etherkit/OpenBeacon2/README.md

# OpenBeacon 2

Documentation for the OpenBeacon 2 Multimode MEPT, which is based on the OpenBeacon project.

## Quick Start

Please visit the [Quick Start Guide](documentation/QuickStart.md) for instructions on how to get up and running with OpenBeacon 2 and for how to use the most common commands.
