etherkit/OpenBeacon2/mechanical/OpenBeacon 2 Acrylic.dxf

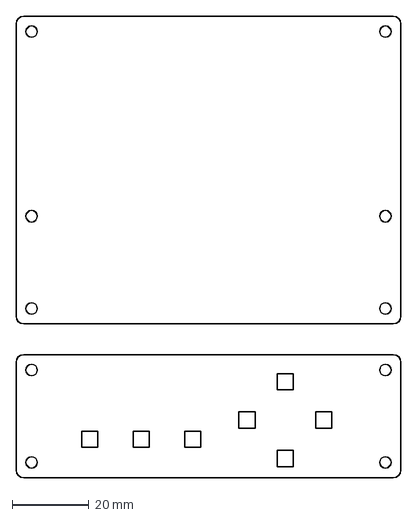
[picture p1: CAD file, 2018-11-19]
mechanical/OpenBeacon 2 Acrylic.dxf
100.0 x 120.0 mm
