etherkit/OpenBeacon2/(threads)

Thread 1 (2019-12-24):

Feature Request - Verbose Mode on Console Command Line

AA7US, 2019-12-24:
When sending commands from the ob2sync console to the OB2, it'd be helpful to receive back some indication like “OK” when a command is understood and successful.  If a command is not recognized or is unsuccessful, receiving back something like “ERR” or “?” would be helpful.  Currently no indication is returned when a command isn't understood by the OB2 firmware.

Thread 2 (2019-12-24):

Feature Request - JS8 Mode

AA7US, 2019-12-24:
Please consider adding JS8 mode transmissions.

JS8 is a free-form chat derivative of FT8 and has 4 speeds.  The Slow speed (30 second transmission at 25 Hz wide) and Normal speed (15 second transmission at 50 Hz wide) would likely be appropriate for the OB2's power level.

See: [http://js8call.com](url)

Source code repository: [https://bitbucket.org/widefido/js8call/src/js8call/](url)

NT7S, 2019-12-24:
This is definitely on my radar. Will add it to the JTEncode repo.

Thread 4 (2020-06-25):

Bug Report - Band Pass Modules "Empty"

AA7US, 2020-06-25:
When firmware dated 12/30/2019 is loaded into Empyrean, the Linux ARM client will report band pass modules are empty in response to "list bands."  Immediately quitting and relaunching the client app eliminates this behavior.  If the Empyrean is reset, the bug comes back and client must again be quit and relaunched to clear it.  Previous firmware builds do not exhibit this bug.
