etherkit/OpenBeacon2/docs/OpenBeacon2_schematic.pdf

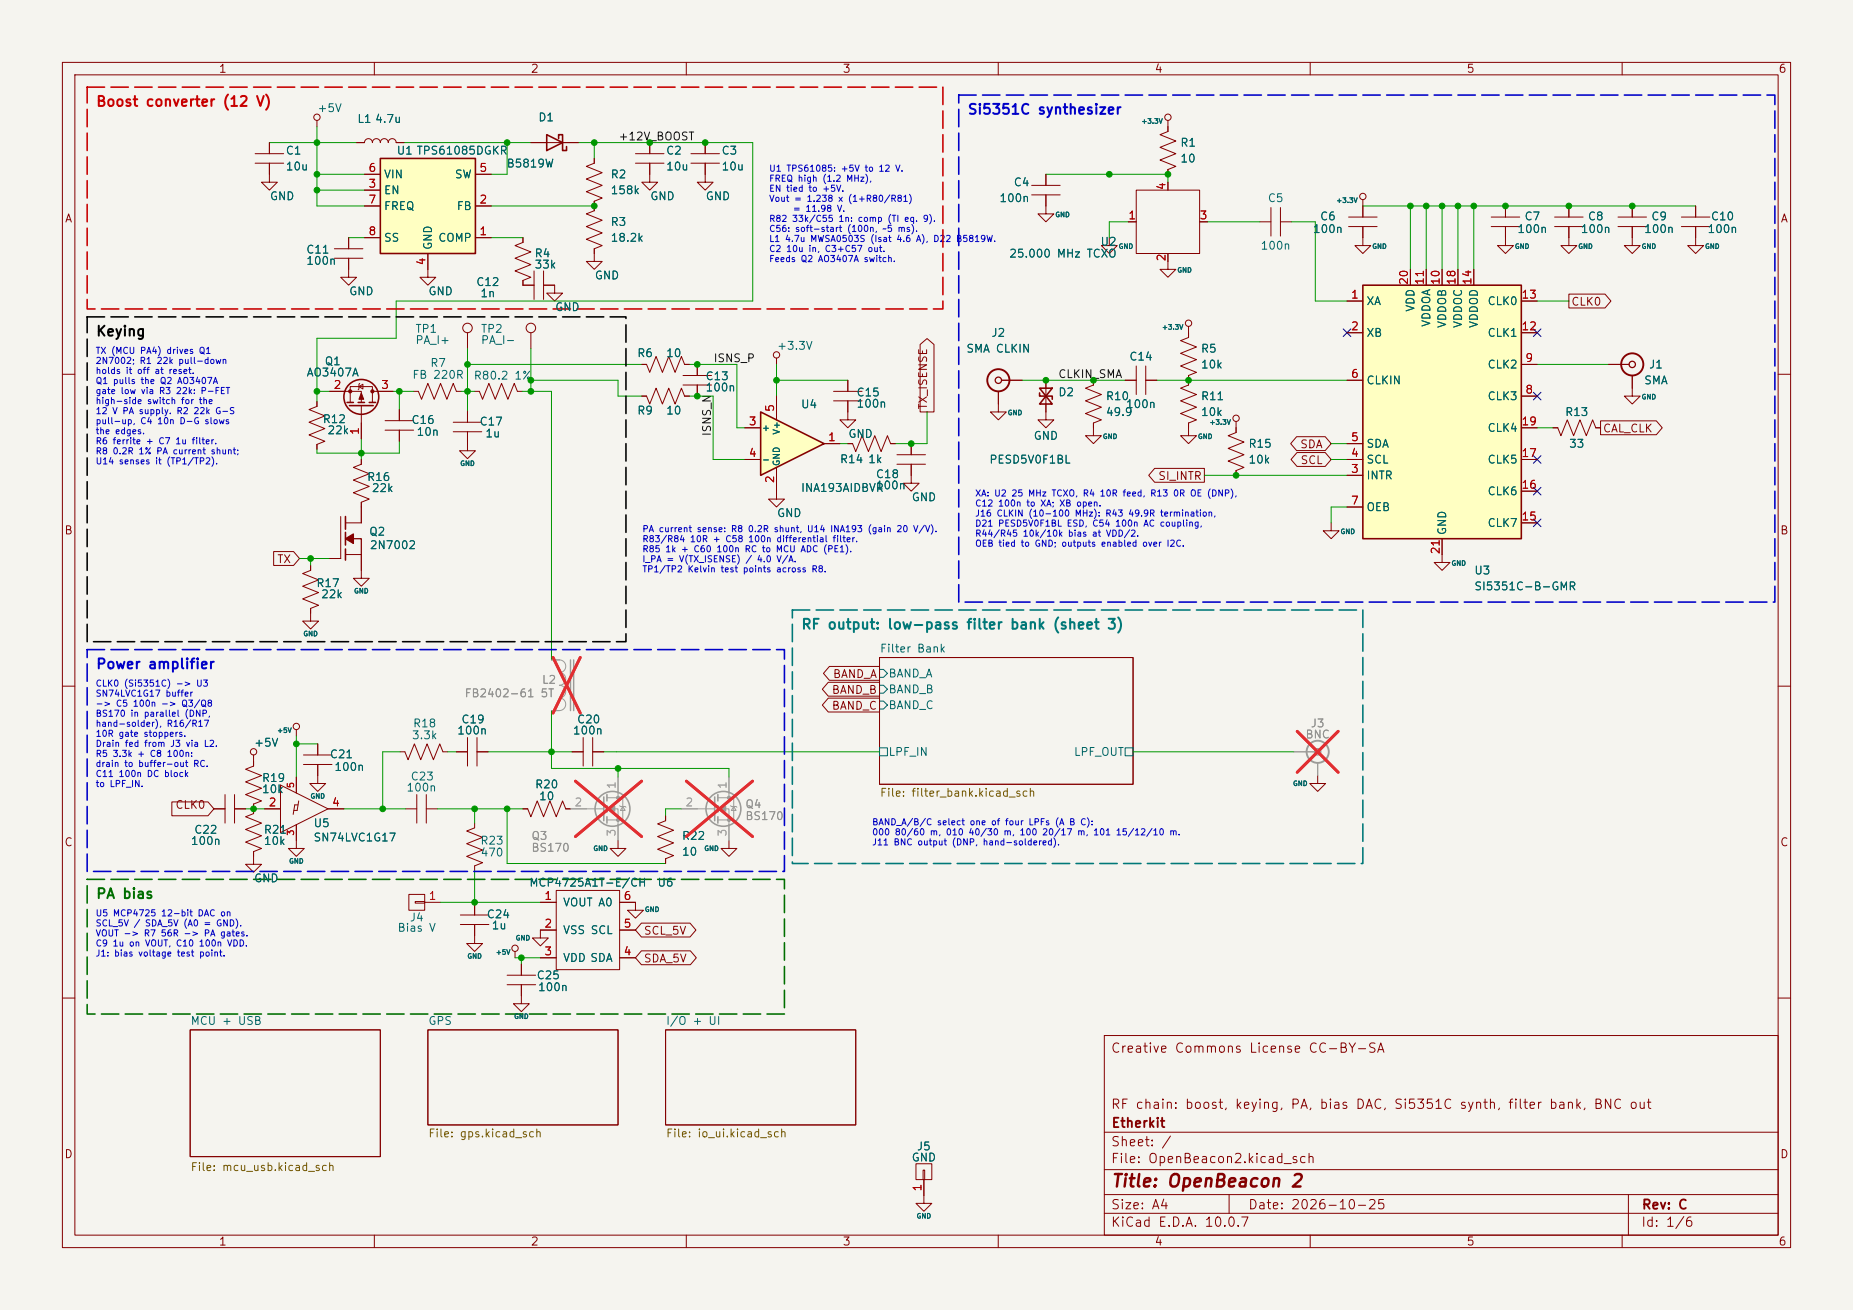
[picture p2: page 1]

ISNS_P +12V_BOOST PA current sense: R8 0.2R shunt, U14 INA193 (gain 20 V/V). R83/R84 10R + C58 100n differential filter. R85 1k + C60 100n RC to MCU ADC (PE1).

U1 TPS61085: +5V to 12 V. FREQ high (1.2 MHz), EN tied to +5V. Vout = 1.238 x (1+R80/R81) = 11.98 V. R82 33k/C55 1n: comp (TI eq. 9). C56: soft-start (100n, ~5 ms). L1 4.7u MWSA0503S (Isat 4.6 A), D22 B5819W. C2 10u in, C3+C57 out. Feeds Q2 AO3407A switch. RF output: low-pass filter bank (sheet 3)

TX (MCU PA4) drives Q1
2N7002; R1 22k pull-down
holds it off at reset. Q1 pulls the Q2 AO3407A gate low via R3 22k: P-FET high-side switch for the 12 V PA supply. R2 22k G-S

pull-up, C4 10n D-G slows
the edges. R6 ferrite + C7 1u filter. R8 0.2R 1% PA current shunt; U14 senses it (TP1/TP2).

SN74LVC1G17 buffer -> C5 100n -> Q3/Q8 BS170 in parallel (DNP, hand-solder), R16/R17

10R gate stoppers. Drain fed from J3 via L2. R5 3.3k + C8 100n: drain to buffer-out RC. C11 100n DC block

U5 MCP4725 12-bit DAC on SCL_5V / SDA_5V (A0 = GND). VOUT -> R7 56R -> PA gates. C9 1u on VOUT, C10 100n VDD. J1: bias voltage test point. PA bias

Creative Commons License CC-BY-SA MCU + USB

RF chain: boost, keying, PA, bias DAC, Si5351C synth, filter bank, BNC out
Etherkit
Sheet: /
File: OpenBeacon2.kicad_sch
Title: OpenBeacon 2

Size: A4 | Rev: C
KiCad E.D.A. 10.0.7 | Id: 1/6

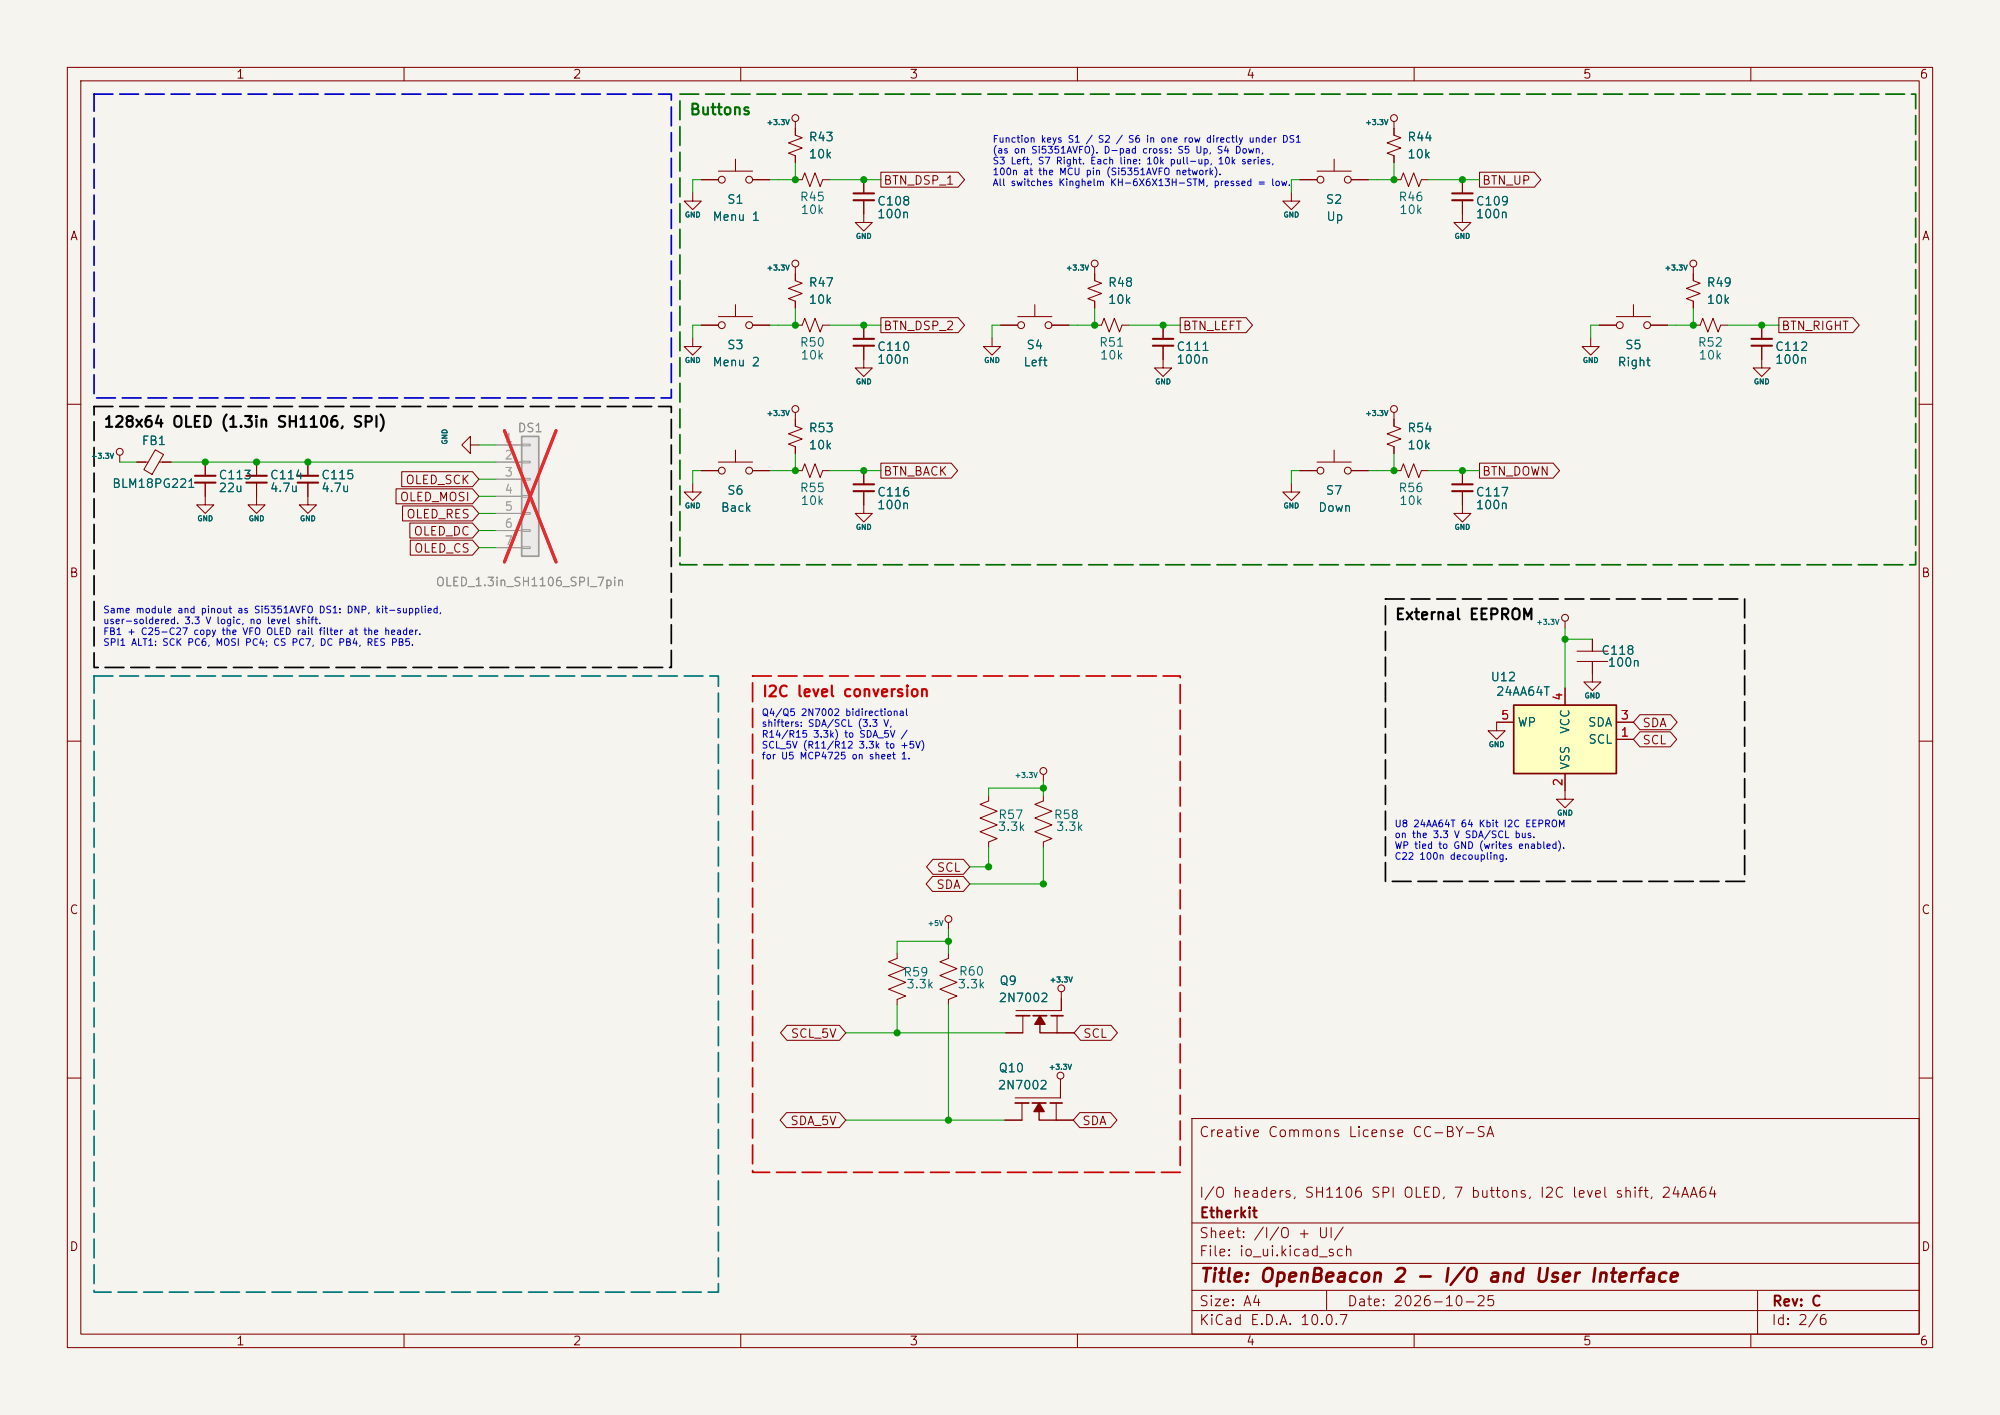
[picture p3: page 2]

Function keys S1 / S2 / S6 in one row directly under DS1

on the 3.3 V SDA/SCL bus. WP tied to GND (writes enabled). C22 100n decoupling. External EEPROM

for U5 MCP4725 on sheet 1. I2C level conversion

Creative Commons License CC-BY-SA

I/O headers, SH1106 SPI OLED, 7 buttons, I2C level shift, 24AA64
Etherkit
Sheet: /I/O + UI/
File: io_ui.kicad_sch
Title: OpenBeacon 2 - I/O and User Interface

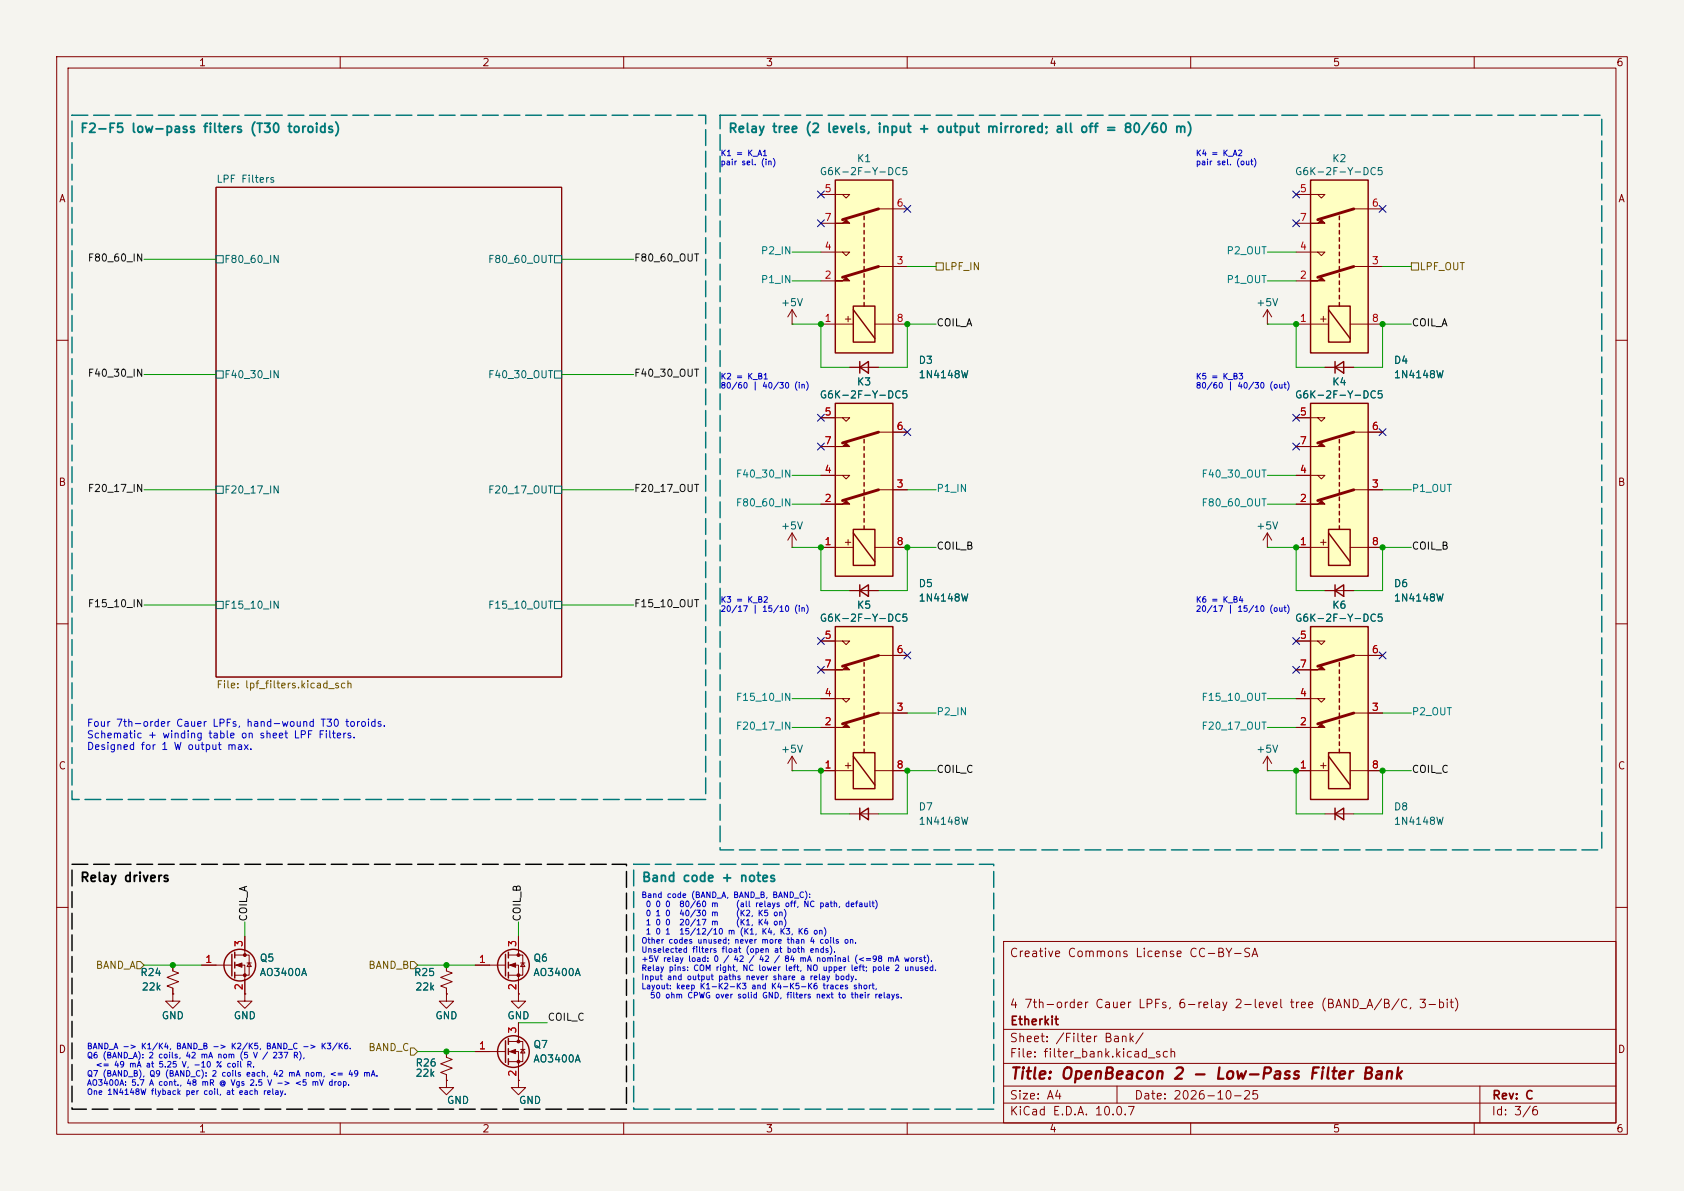
[picture p4: page 3]

F20_17_IN F2-F5 low-pass filters (T30 toroids)

Relay tree (2 levels, input + output mirrored; all off = 80/60 m)
pair sel. (in)

Input and output paths never share a relay body. Layout: keep K1-K2-K3 and K4-K5-K6 traces short, 50 ohm CPWG over solid GND, filters next to their relays. Q6

Creative Commons License CC-BY-SA

4 7th-order Cauer LPFs, 6-relay 2-level tree (BAND_A/B/C, 3-bit)
Etherkit
Sheet: /Filter Bank/
File: filter_bank.kicad_sch
Title: OpenBeacon 2 - Low-Pass Filter Bank

BAND_A -> K1/K4, BAND_B -> K2/K5, BAND_C -> K3/K6. Q6 (BAND_A): 2 coils, 42 mA nom (5 V / 237 R), <= 49 mA at 5.25 V, -10 % coil R. Q7 (BAND_B), Q9 (BAND_C): 2 coils each, 42 mA nom, <= 49 mA. AO3400A: 5.7 A cont., 48 mR @ Vgs 2.5 V -> <5 mV drop. One 1N4148W flyback per coil, at each relay.

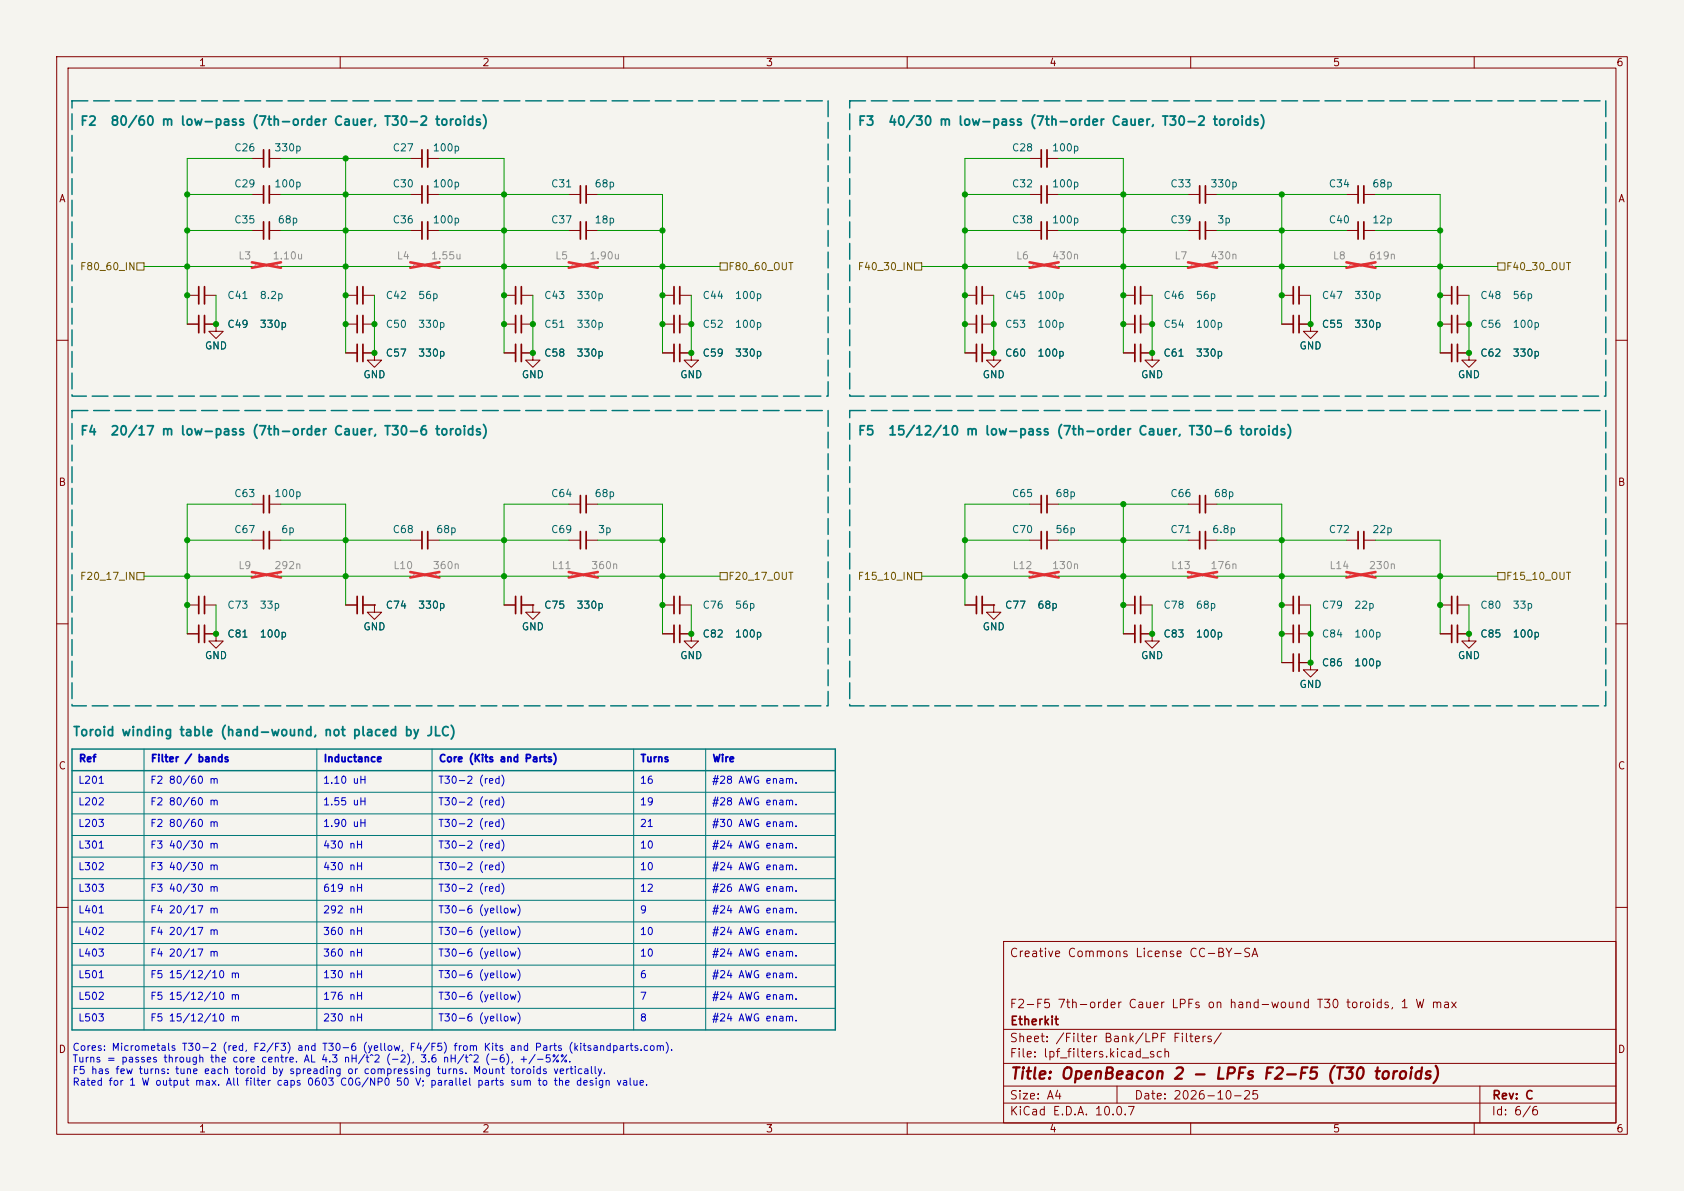
[picture p5: page 4]

F2 80/60 m low-pass (7th-order Cauer, T30-2 toroids)

F3 40/30 m low-pass (7th-order Cauer, T30-2 toroids)

F5 15/12/10 m low-pass (7th-order Cauer, T30-6 toroids)

Ref | Filter / bands | Inductance | | | #30 AWG enam. #28 AWG enam. Toroid winding table (hand-wound, not placed by JLC)

L301 | F3 40/30 m | 430 nH | T30-2 (red) | 19 Core (Kits and Parts) Turns | #24 AWG enam. F4 20/17 m

L203 | F2 80/60 m | 1.90 uH | T30-2 (red) | 12 21 | #26 AWG enam. T30-2 (red) T30-2 (red)
L201 | F2 80/60 m | 1.10 uH

L401 | F4 20/17 m | 292 nH | | 10 | #24 AWG enam. T30-6 (yellow) T30-2 (red)

L402 | | 360 nH | T30-6 (yellow)

F2-F5 7th-order Cauer LPFs on hand-wound T30 toroids, 1 W max Creative Commons License CC-BY-SA

Etherkit
Sheet: /Filter Bank/LPF Filters/
File: lpf_filters.kicad_sch
Title: OpenBeacon 2 - LPFs F2-F5 (T30 toroids)

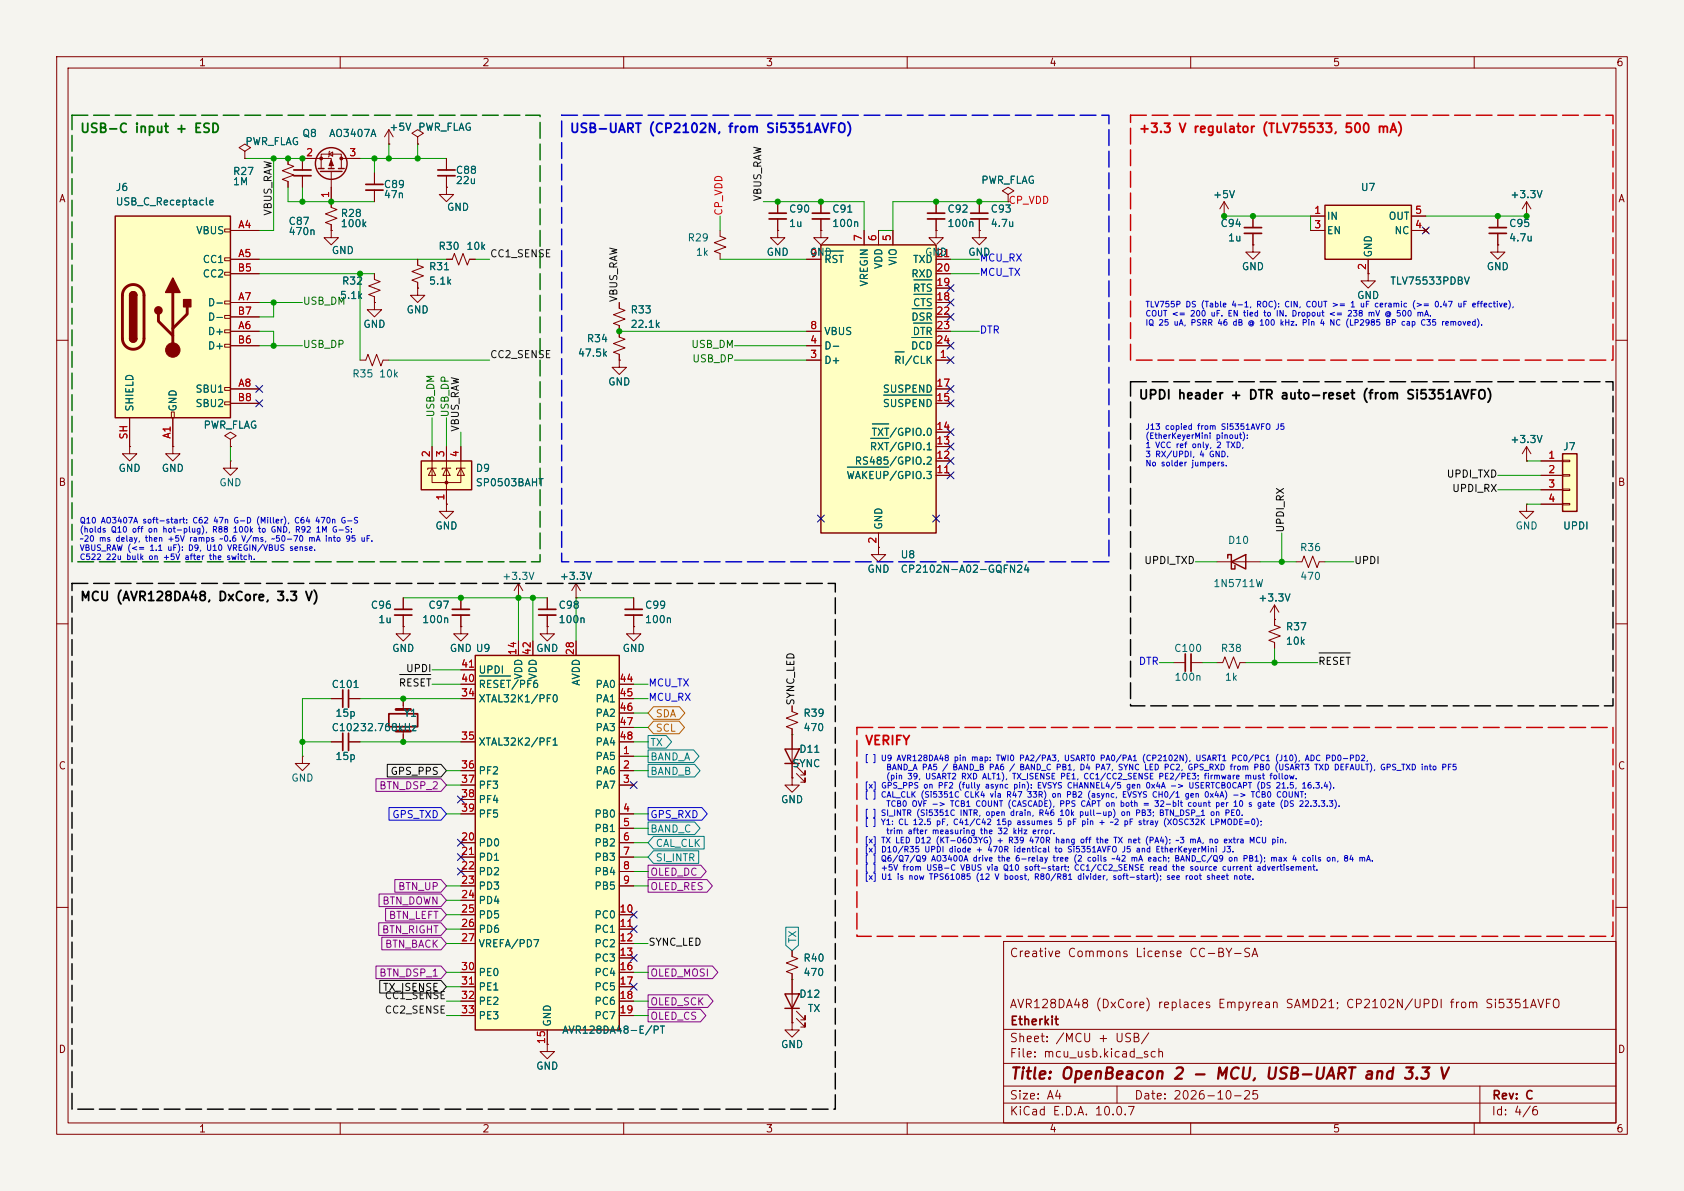
[picture p6: page 5]

SUSPEND 15 SUSPEND 17 CTS 18 RTS 19 RXD 20 TXD 21 DSR 22 DTR 23 DCD 24 U8CP2102N-A02-GQFN24 C91

SUSPEND 15 SUSPEND 17 CTS 18 RTS 19 RXD 20 TXD 21 DSR 22 DTR 23 DCD 24 C91

TLV755P DS (Table 4-1, ROC): CIN, COUT >= 1 uF ceramic (>= 0.47 uF effective), COUT <= 200 uF. EN tied to IN. Dropout <= 238 mV @ 500 mA.

IQ 25 uA, PSRR 46 dB @ 100 kHz. Pin 4 NC (LP2985 BP cap C35 removed).

Creative Commons License CC-BY-SA GND A1

(pin 39, USART2 RXD ALT1), TX_ISENSE PE1, CC1/CC2_SENSE PE2/PE3; firmware must follow. [x] GPS_PPS on PF2 (fully async pin): EVSYS CHANNEL4/5 gen 0x4A -> USERTCB0CAPT (DS 21.5, 16.3.4). [ ] CAL_CLK (Si5351C CLK4 via R47 33R) on PB2 (async, EVSYS CH0/1 gen 0x4A) -> TCB0 COUNT; TCB0 OVF -> TCB1 COUNT (CASCADE), PPS CAPT on both = 32-bit count per 10 s gate (DS 22.3.3.3). [ ] SI_INTR (Si5351C INTR, open drain, R46 10k pull-up) on PB3; BTN_DSP_1 on PE0. [ ] Y1: CL 12.5 pF, C41/C42 15p assumes 5 pF pin + ~2 pF stray (XOSC32K LPMODE=0); trim after measuring the 32 kHz error. [x] TX LED D12 (KT-0603YG) + R39 470R hang off the TX net (PA4); ~3 mA, no extra MCU pin. [x] D10/R35 UPDI diode + 470R identical to Si5351AVFO J5 and EtherKeyerMini J3. [ ] Q6/Q7/Q9 AO3400A drive the 6-relay tree (2 coils ~42 mA each; BAND_C/Q9 on PB1); max 4 coils on, 84 mA. [ ] +5V from USB-C VBUS via Q10 soft-start; CC1/CC2_SENSE read the source current advertisement. [x] U1 is now TPS61085 (12 V boost, R80/R81 divider, soft-start); see root sheet note. UPDI header + DTR auto-reset (from Si5351AVFO)

(EtherKeyerMini pinout): 1 VCC ref only, 2 TXD, 3 RX/UPDI, 4 GND. No solder jumpers. MCU (AVR128DA48, DxCore, 3.3 V)

[ ] U9 AVR128DA48 pin map: TWI0 PA2/PA3, USART0 PA0/PA1 (CP2102N), USART1 PC0/PC1 (J10), ADC PD0-PD2, BAND_A PA5 / BAND_B PA6 / BAND_C PB1, D4 PA7, SYNC LED PC2, GPS_RXD from PB0 (USART3 TXD DEFAULT), GPS_TXD into PF5

AVR128DA48 (DxCore) replaces Empyrean SAMD21; CP2102N/UPDI from Si5351AVFO
Etherkit
Sheet: /MCU + USB/
File: mcu_usb.kicad_sch
Title: OpenBeacon 2 - MCU, USB-UART and 3.3 V

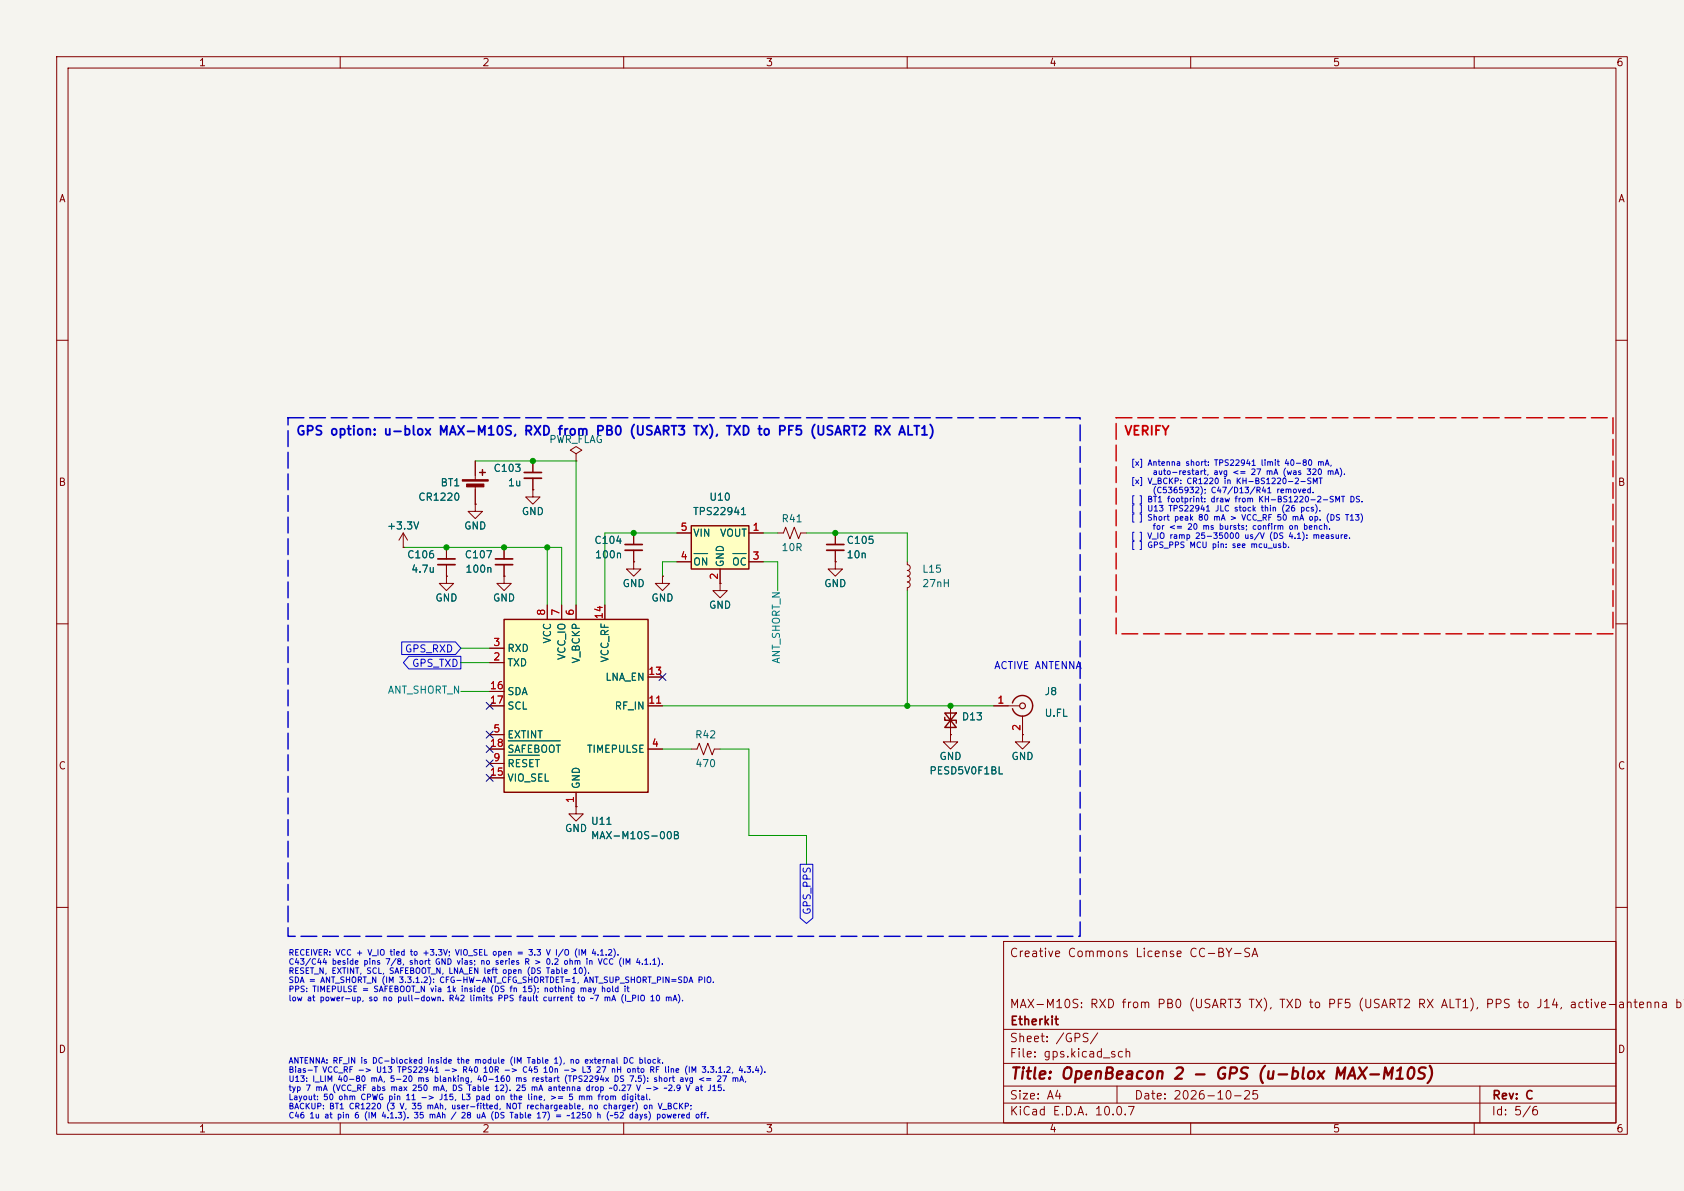
[picture p7: page 6]

[x] Antenna short: TPS22941 limit 40-80 mA, auto-restart, avg <= 27 mA (was 320 mA). [x] V_BCKP: CR1220 in KH-BS1220-2-SMT

(C5365932); C47/D13/R41 removed. [ ] BT1 footprint: draw from KH-BS1220-2-SMT DS. [ ] U13 TPS22941 JLC stock thin (26 pcs). [ ] Short peak 80 mA > VCC_RF 50 mA op. (DS T13)

for <= 20 ms bursts; confirm on bench. [ ] V_IO ramp 25-35000 us/V (DS 4.1): measure. [ ] GPS_PPS MCU pin: see mcu_usb. GND

RECEIVER: VCC + V_IO tied to +3.3V; VIO_SEL open = 3.3 V I/O (IM 4.1.2). C43/C44 beside pins 7/8, short GND vias; no series R > 0.2 ohm in VCC (IM 4.1.1). RESET_N, EXTINT, SCL, SAFEBOOT_N, LNA_EN left open (DS Table 10). SDA = ANT_SHORT_N (IM 3.3.1.2): CFG-HW-ANT_CFG_SHORTDET=1, ANT_SUP_SHORT_PIN=SDA PIO. PPS: TIMEPULSE = SAFEBOOT_N via 1k inside (DS fn 15); nothing may hold it

Creative Commons License CC-BY-SA

low at power-up, so no pull-down. R42 limits PPS fault current to ~7 mA (I_PIO 10 mA).

MAX-M10S: RXD from PB0 (USART3 TX), TXD to PF5 (USART2 RX ALT1), PPS to J14, active-antenna bias-T, CR1220
Etherkit
Sheet: /GPS/
File: gps.kicad_sch
Title: OpenBeacon 2 - GPS (u-blox MAX-M10S)

ANTENNA: RF_IN is DC-blocked inside the module (IM Table 1), no external DC block. Bias-T VCC_RF -> U13 TPS22941 -> R40 10R -> C45 10n -> L3 27 nH onto RF line (IM 3.3.1.2, 4.3.4). U13: I_LIM 40-80 mA, 5-20 ms blanking, 40-160 ms restart (TPS2294x DS 7.5): short avg <= 27 mA, typ 7 mA (VCC_RF abs max 250 mA, DS Table 12). 25 mA antenna drop ~0.27 V -> ~2.9 V at J15. Layout: 50 ohm CPWG pin 11 -> J15, L3 pad on the line, >= 5 mm from digital. BACKUP: BT1 CR1220 (3 V, 35 mAh, user-fitted, NOT rechargeable, no charger) on V_BCKP; C46 1u at pin 6 (IM 4.1.3). 35 mAh / 28 uA (DS Table 17) = ~1250 h (~52 days) powered off.
