etherkit/OpenBeacon2/pcb/OpenBeacon2.pdf

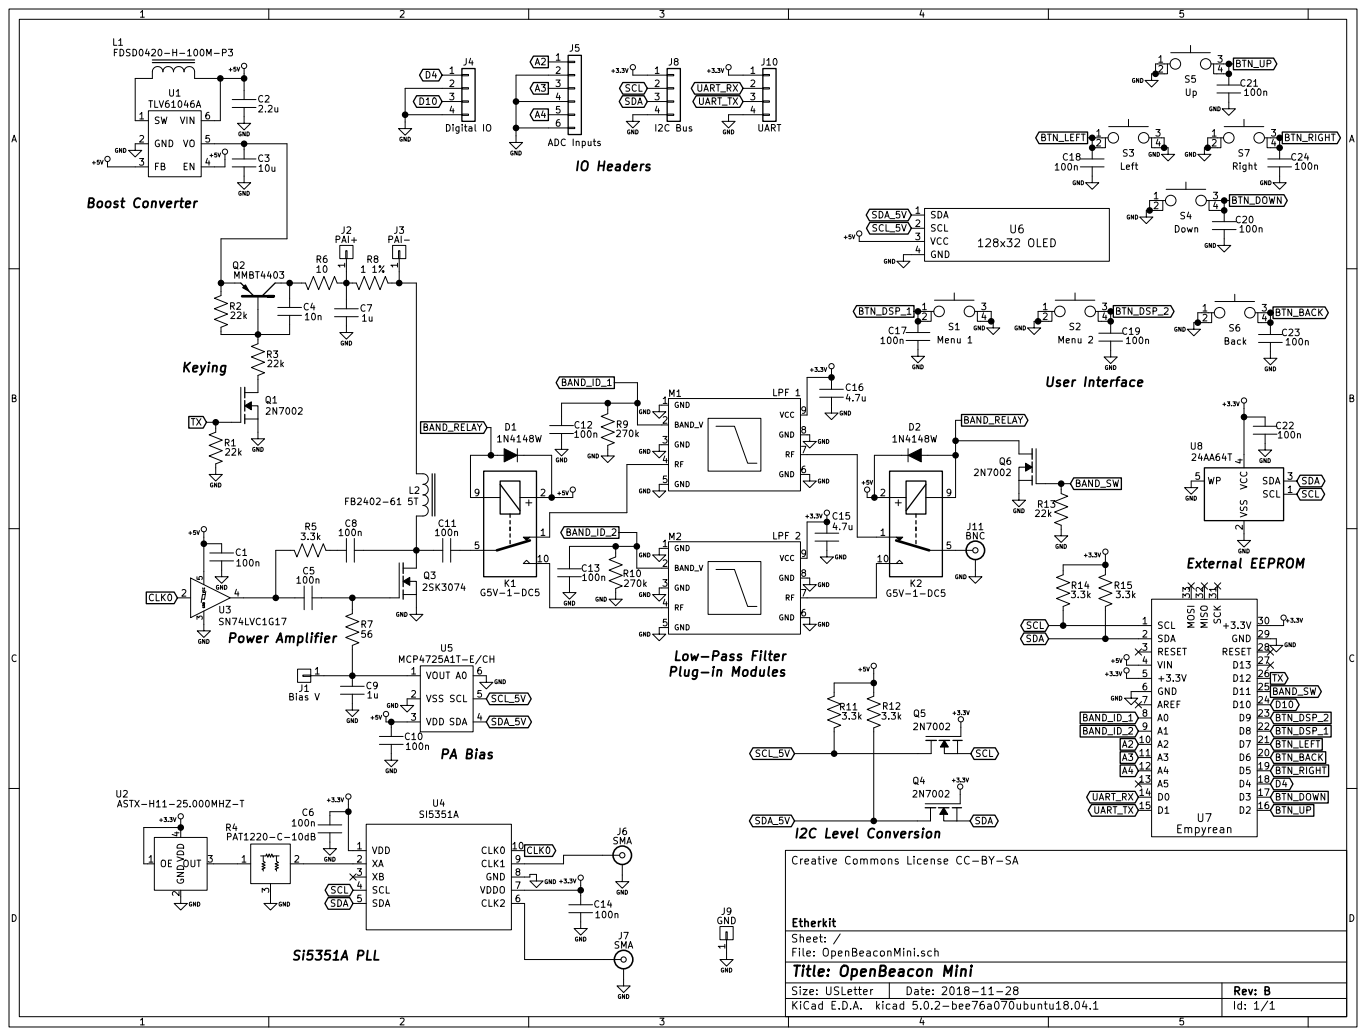
[picture p8: page 1]

4 U2ASTX-H11-25.000MHZ-T VDD 1 CLK0 10 XA 2 XB 3 SCL 4 SDA 5 CLK2 6 VDDO 7 GND 8 CLK1 9 U4 SI5351A

File: OpenBeaconMini.sch Sheet: / Etherkit Creative Commons License CC-BY-SA

Id: 1/1 Title: OpenBeacon Mini
