etherkit/OpenBeacon2/mechanical/OpenBeacon 2 Acrylic.pdf

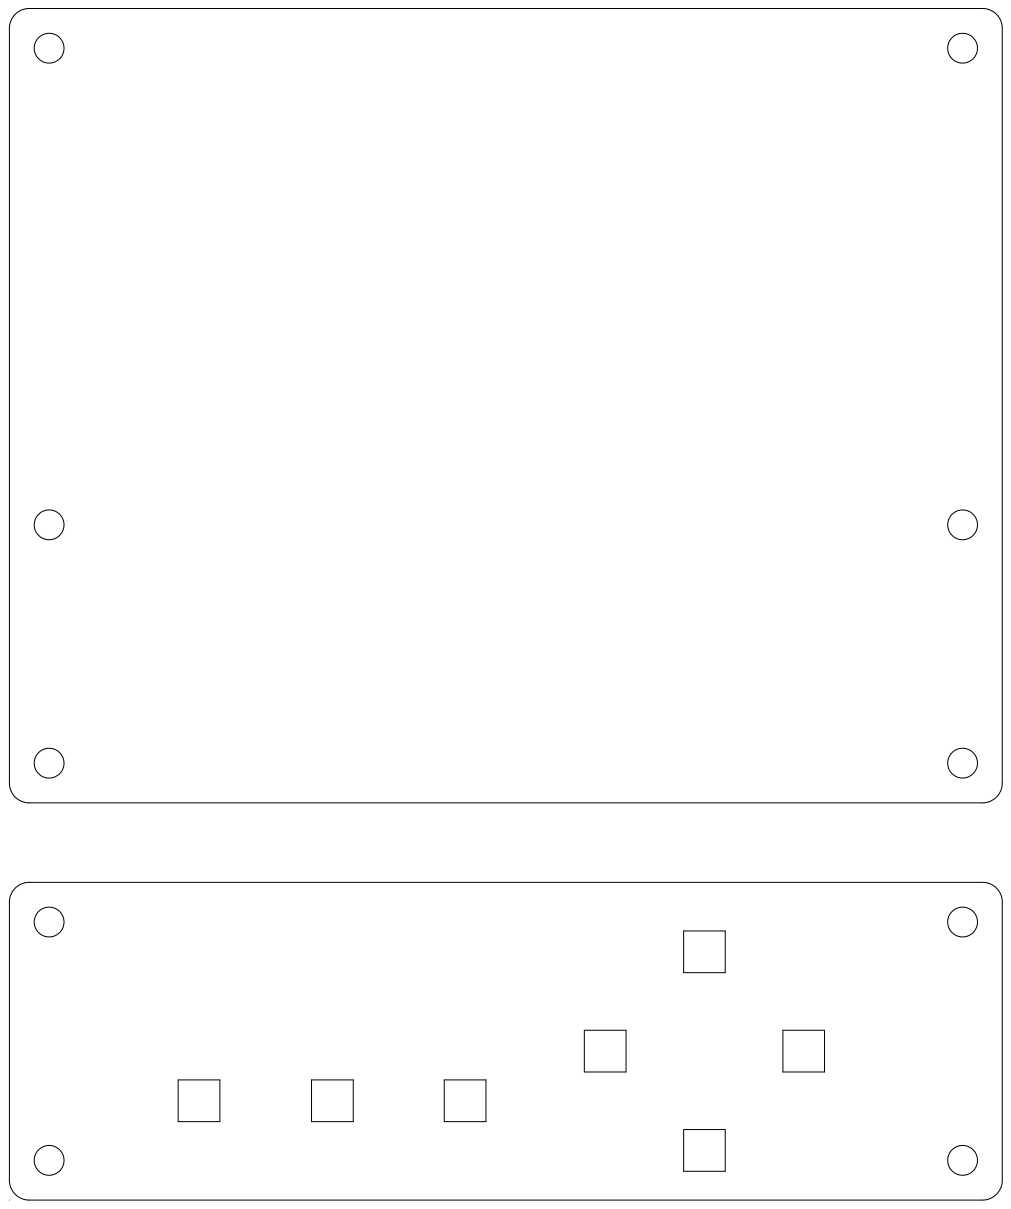
[picture p9: page 1]
