etherkit/OpenBeacon2/documentation/OpenBeacon2.pdf

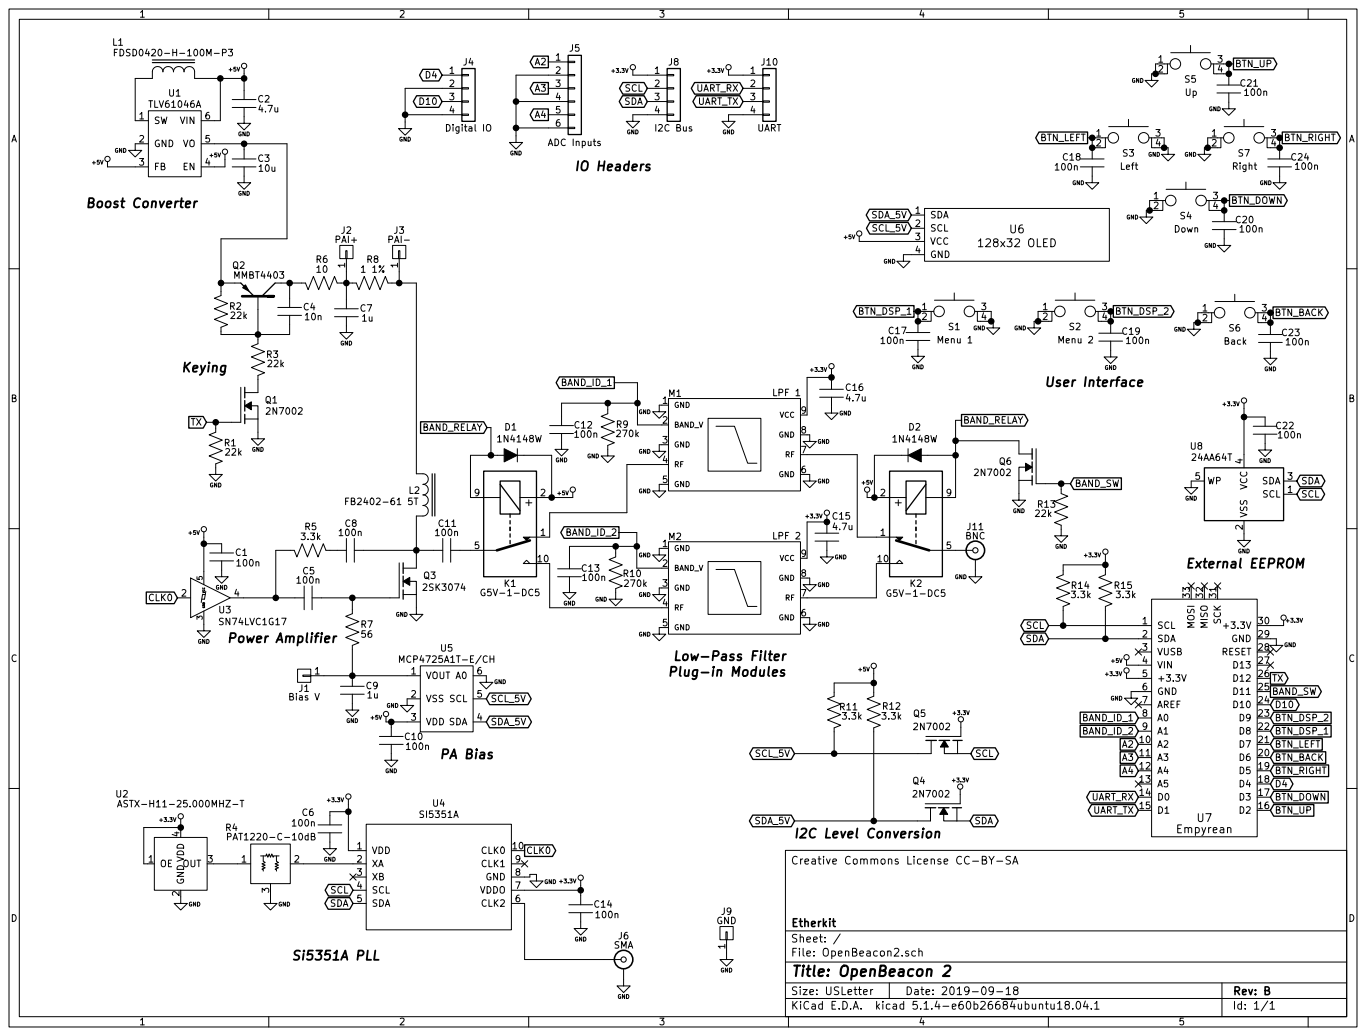
[picture p10: page 1]

File: OpenBeacon2.sch Sheet: / Etherkit Creative Commons License CC-BY-SA
