etherkit/OpenBeacon2/pcb/OpenBeacon2.kicad_pcb

## KiCad design pcb/OpenBeacon2.kicad_pcb (2026-10-28)

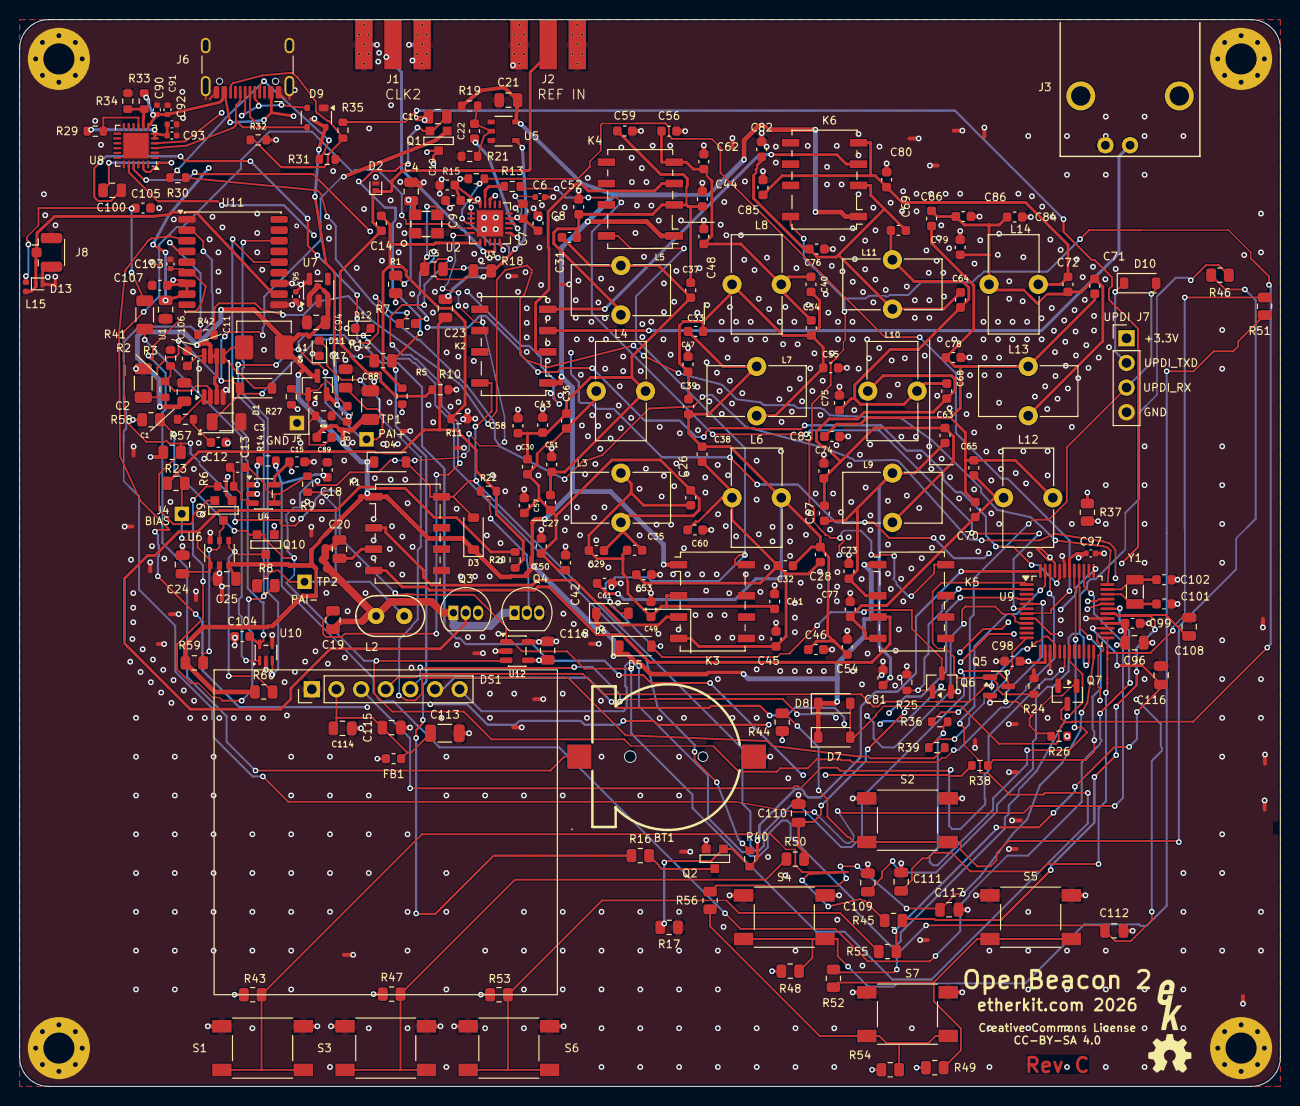
[picture p11: board OpenBeacon2.kicad_pcb from above]

Board: 4 copper layers, 130.0 x 110.0 mm, 261 parts (0 on the bottom side), 123 nets.

Parts:
BT1: CR1220; BAT-SMD_KH-CR1220-2
C1: 10u; C_0805_2012Metric
C2, C3: 10u; C_1206_3216Metric
C4, C5, C19, C20, C21, C23, C25, C100, C108, C109, C110, C111, C112, C116, C117, C118: 100n; C_0805_2012Metric
C6, C91, C92, C97: 100n; C_0402_1005Metric
C7, C8, C9, C10, C11, C13, C14, C15, C18, C22, C98, C99, C104, C107: 100n; C_0603_1608Metric
C12: 1n; C_0603_1608Metric
C16: 10n; C_0805_2012Metric
C17, C24, C94, C96: 1u; C_0805_2012Metric
C26, C33, C43, C47, C49, C50, C51, C55, C57, C58, C59, C61, C62, C74, C75: 330p; C_0603_1608Metric
C27, C28, C29, C30, C32, C36, C38, C44, C45, C52, C53, C54, C56, C60, C63, C81, C82, C83, C84, C85, C86: 100p; C_0603_1608Metric
C31, C34, C35, C64, C65, C66, C68, C77, C78: 68p; C_0603_1608Metric
C37: 18p; C_0603_1608Metric
C39, C69: 3p; C_0603_1608Metric
C40: 12p; C_0603_1608Metric
C41: 8.2p; C_0603_1608Metric
C42, C46, C48, C70, C76: 56p; C_0603_1608Metric
C67: 6p; C_0603_1608Metric
C71: 6.8p; C_0603_1608Metric
C72, C79: 22p; C_0603_1608Metric
C73, C80: 33p; C_0603_1608Metric
C87: 470n; C_0603_1608Metric
C88, C113: 22u; C_1206_3216Metric
C89: 47n; C_0603_1608Metric
C90, C103: 1u; C_0402_1005Metric
C93, C95: 4.7u; C_0402_1005Metric
C101, C102: 15p; C_0603_1608Metric
C105: 10n; C_0603_1608Metric
C106, C114, C115: 4.7u; C_0805_2012Metric
D1: B5819W; D_SOD-123
D2, D13: PESD5V0F1BL; D_SOD-882
D3, D4, D5, D6, D7, D8: 1N4148W; D_SOD-123
D9: SP0503BAHT; SOT-143
D10: 1N5711W; D_SOD-123
D11: SYNC; LED_0603_1608Metric
D12: TX; LED_0603_1608Metric
DS1: OLED_1.3in_SH1106_SPI_7pin; OLED_1.3in_SH1106_PinHeader_1x07_P2.54mm
FB1: BLM18PG221; L_0603_1608Metric
H1, H2, H3, H4: MountingHole_M3; MountingHole_3.2mm_M3_Pad_Via
J1: SMA; SMA-ENDLAUNCH
J2: SMA CLKIN; SMA-ENDLAUNCH
J3: BNC; BNC-AMPHENOL-31-5431-10RFX
J4: Bias V; Measurement_Point_Square-TH_Small
J5: GND; Measurement_Point_Square-TH_Small
J6: USB_C_Receptacle; USB_C_Receptacle_HCTL_HC-TYPE-C-16P-01A
J7: UPDI; PinHeader_1x04_P2.54mm_Vertical
J8: U.FL; U.FL_Hirose_U.FL-R-SMT-1_Vertical
K1, K2, K3, K4, K5, K6: G6K-2F-Y-DC5; Relay_DPDT_Omron_G6K-2F-Y
L1: 4.7u; L_Sunlord_MWSA0503S
L2: FB2402-61 5T; BN2402
L3: 1.10u; L_Toroid_Vertical_L10.0mm_W5.0mm_P5.08mm
L4: 1.55u; L_Toroid_Vertical_L10.0mm_W5.0mm_P5.08mm
L5: 1.90u; L_Toroid_Vertical_L10.0mm_W5.0mm_P5.08mm
L6, L7: 430n; L_Toroid_Vertical_L10.0mm_W5.0mm_P5.08mm
L8: 619n; L_Toroid_Vertical_L10.0mm_W5.0mm_P5.08mm
L9: 292n; L_Toroid_Vertical_L10.0mm_W5.0mm_P5.08mm
L10, L11: 360n; L_Toroid_Vertical_L10.0mm_W5.0mm_P5.08mm
L12: 130n; L_Toroid_Vertical_L10.0mm_W5.0mm_P5.08mm
L13: 176n; L_Toroid_Vertical_L10.0mm_W5.0mm_P5.08mm
L14: 230n; L_Toroid_Vertical_L10.0mm_W5.0mm_P5.08mm
L15: 27nH; L_0402_1005Metric
LOGO1: LOGO; EtherkitLogoSmall
LOGO2: LOGO; OSHWLogo4mm
Q1: AO3407A; SOT23-MMBT440X
Q2, Q9, Q10: 2N7002; SOT23-2N7002
Q3, Q4: BS170; TO-92_Inline
Q5, Q6, Q7: AO3400A; SOT-23
Q8: AO3407A; SOT-23
R1: 10; R_0805_2012Metric
R2: 158k; R_0603_1608Metric
R3: 18.2k; R_0603_1608Metric
R4: 33k; R_0603_1608Metric
R5, R11, R15, R19, R21, R30, R35: 10k; R_0603_1608Metric
R6, R9, R20, R22: 10; R_0603_1608Metric
R7: FB 220R; L_0603_1608Metric
R8: 0.2 1%; R_0805_2012Metric
R10: 49.9; R_0603_1608Metric
R12, R16, R17: 22k; R_0805_2012Metric
R13: 33; R_0603_1608Metric
R14, R29, R38: 1k; R_0603_1608Metric
R18, R57, R58, R59, R60: 3.3k; R_0805_2012Metric
R23: 470; R_0805_2012Metric
R24, R25, R26: 22k; R_0603_1608Metric
R27: 1M; R_0603_1608Metric
R28: 100k; R_0603_1608Metric
R31, R32: 5.1k; R_0603_1608Metric
R33: 22.1k; R_0603_1608Metric
R34: 47.5k; R_0603_1608Metric
R36, R39, R40, R42: 470; R_0603_1608Metric
R37, R43, R44, R45, R46, R47, R48, R49, R50, R51, R52, R53, R54, R55, R56: 10k; R_0805_2012Metric
R41: 10R; R_1206_3216Metric
S1: Menu 1; SW_Push_6x6mm_SMD_KH-6X6X13H-STM
S2: Up; SW_Push_6x6mm_SMD_KH-6X6X13H-STM
S3: Menu 2; SW_Push_6x6mm_SMD_KH-6X6X13H-STM
S4: Left; SW_Push_6x6mm_SMD_KH-6X6X13H-STM
S5: Right; SW_Push_6x6mm_SMD_KH-6X6X13H-STM
S6: Back; SW_Push_6x6mm_SMD_KH-6X6X13H-STM
S7: Down; SW_Push_6x6mm_SMD_KH-6X6X13H-STM
TP1: PA_I+; Measurement_Point_Square-TH_Small
TP2: PA_I-; Measurement_Point_Square-TH_Small
U1: TPS61085DGKR; VSSOP-8_3x3mm_P0.65mm
U2: 25.000 MHz TCXO; ASTX-H11-25.000MHZ-T
U3: SI5351C-B-GMR; QFN-20-1EP_4x4mm_P0.5mm_EP2.7x2.7mm
U4: INA193AIDBVR; SOT-23-5
U5: SN74LVC1G17; SOT23-5
U6: MCP4725A1T-E/CH; SOT23-6
U7: TLV75533PDBV; SOT-23-5
U8: CP2102N-A02-GQFN24; QFN-24-1EP_4x4mm_P0.5mm_EP2.6x2.6mm
U9: AVR128DA48-E/PT; TQFP-48_7x7mm_P0.5mm
U10: TPS22941; SOT-353_SC-70-5
U11: MAX-M10S-00B; ublox_MAX
U12: 24AA64T; SOT-23-5
Y1: 32.768kHz; Crystal_SMD_3215-2Pin_3.2x1.5mm

Connections:
+3.3V: C6.1, C7.1, C8.1, C9.1, C10.1, C15.1, C95.1, C96.1, C97.1, C98.1, C99.1, C106.1, C107.1, C118.1, FB1.1, J7.1, Q9.2, Q10.2, R1.1, R5.1, R15.1, R37.1, R43.1, R44.1, R47.1, R48.1, R49.1, R53.1, R54.1, R57.1, R58.1, U3.10, U3.11, U3.14, U3.18, U3.20, U4.5, U7.5, U9.14, U9.28, U9.42, U11.7, U11.8, U12.4
+5V: C1.1, C21.1, C25.1, C88.1, C89.1, C94.1, D3.1, D4.1, D5.1, D6.1, D7.1, D8.1, K1.1, K2.1, K3.1, K4.1, K5.1, K6.1, L1.1, Q8.3, R19.1, R59.1, R60.1, U1.3, U1.6, U1.7, U5.5, U6.3, U7.1, U7.3
/+12V_BOOST: C2.1, C3.1, D1.1, Q1.2, R2.1, R12.1
/CLKIN_SMA: C14.1, D2.1, J2.1, R10.1
/Filter Bank/COIL_A: D3.2, D4.2, K1.8, K2.8, Q5.3
/Filter Bank/COIL_B: D5.2, D6.2, K3.8, K4.8, Q6.3
/Filter Bank/COIL_C: D7.2, D8.2, K5.8, K6.8, Q7.3
/Filter Bank/F15_10_IN: C65.1, C70.1, C77.1, K5.4, L12.1
/Filter Bank/F15_10_OUT: C72.2, C80.1, C85.1, K6.4, L14.2
/Filter Bank/F20_17_IN: C63.1, C67.1, C73.1, C81.1, K5.2, L9.1
/Filter Bank/F20_17_OUT: C64.2, C69.2, C76.1, C82.1, K6.2, L11.2
/Filter Bank/F40_30_IN: C28.1, C32.1, C38.1, C45.1, C53.1, C60.1, K3.4, L6.1
/Filter Bank/F40_30_OUT: C34.2, C40.2, C48.1, C56.1, C62.1, K4.4, L8.2
/Filter Bank/F80_60_IN: C26.1, C29.1, C35.1, C41.1, C49.1, K3.2, L3.1
/Filter Bank/F80_60_OUT: C31.2, C37.2, C44.1, C52.1, C59.1, K4.2, L5.2
/Filter Bank/LPF_IN: C20.1, K1.3
/Filter Bank/LPF_OUT: J3.1, K2.3
/Filter Bank/P1_IN: K1.2, K3.3
/Filter Bank/P1_OUT: K2.2, K4.3
/Filter Bank/P2_IN: K1.4, K5.3
/Filter Bank/P2_OUT: K2.4, K6.3
/GPS/ANT_SHORT_N: U10.3, U11.16
/ISNS_N: C13.2, R9.2, U4.4
/ISNS_P: C13.1, R6.2, U4.3
/MCU + USB/CC1_SENSE: R30.2, U9.32
/MCU + USB/CC2_SENSE: R35.2, U9.33
/MCU + USB/CP_VDD: C92.1, C93.1, R29.1, U8.5, U8.6
/MCU + USB/DTR: C100.1, U8.23
/MCU + USB/MCU_RX: U8.21, U9.45
/MCU + USB/MCU_TX: U8.20, U9.44
/MCU + USB/SYNC_LED: R39.1, U9.12
/MCU + USB/UPDI: R36.2, U9.41
/MCU + USB/UPDI_RX: D10.2, J7.3, R36.1
/MCU + USB/UPDI_TXD: D10.1, J7.2
/MCU + USB/USB_DM: D9.2, J6.A7, J6.B7, U8.4
/MCU + USB/USB_DP: D9.3, J6.A6, J6.B6, U8.3
/MCU + USB/VBUS_RAW: C87.1, C90.1, C91.1, D9.4, J6.A4, J6.A9, J6.B4, J6.B9, Q8.2, R27.1, R33.1, U8.7
/MCU + USB/~RESET: R37.2, R38.2, U9.40
BAND_A: Q5.1, R24.1, U9.1
BAND_B: Q6.1, R25.1, U9.2
BAND_C: Q7.1, R26.1, U9.5
BTN_BACK: C116.1, R55.2, U9.27
BTN_DOWN: C117.1, R56.2, U9.24
BTN_DSP_1: C108.1, R45.2, U9.30
BTN_DSP_2: C110.1, R50.2, U9.37
BTN_LEFT: C111.1, R51.2, U9.25
BTN_RIGHT: C112.1, R52.2, U9.26
BTN_UP: C109.1, R46.2, U9.23
CAL_CLK: R13.2, U9.6
CLK0: C22.1, U3.13
GND: BT1.2, C1.2, C2.2, C3.2, C4.2, C6.2, C7.2, C8.2, C9.2, C10.2, C11.2, C12.2, C15.2, C17.2, C18.2, C21.2, C24.2, C25.2, C41.2, C42.2, C43.2, C44.2, C45.2, C46.2, C47.2, C48.2, C49.2, C50.2, C51.2, C52.2, C53.2, C54.2, C55.2, C56.2, C57.2, C58.2, C59.2, C60.2, C61.2, C62.2, C73.2, C74.2, C75.2, C76.2, C77.2, C78.2, C79.2, C80.2, C81.2, C82.2, C83.2, C84.2, C85.2, C86.2, C88.2, C90.2, C91.2, C92.2, C93.2, C94.2, C95.2, C96.2, C97.2, C98.2, C99.2, C101.1, C102.1, C103.2, C104.2, C105.2, C106.2, C107.2, C108.2, C109.2, C110.2, C111.2, C112.2, C113.2, C114.2, C115.2, C116.2, C117.2, C118.2, D2.2, D9.1, D11.1, D12.1, D13.2, DS1.1, H1.1, H2.1, H3.1, H4.1, J1.2, J2.2, J3.2, J5.1, J6.A1, J6.A12, J6.B1, J6.B12, J6.SH, J7.4, J8.2, Q2.1, Q3.3, Q4.3, Q5.2, Q6.2, Q7.2, R3.2, R10.2, R11.2, R17.2, R21.2, R24.2, R25.2, R26.2, R28.2, R31.2, R32.2, R34.2, S1.1, S2.1, S3.1, S4.1, S5.1, S6.1, S7.1, U1.4, U2.1, U2.2, U3.7, U3.21, U4.2, U5.3, U6.2, U6.6, U7.2, U8.2, U8.25, U9.15, U9.29, U9.43, U10.2, U10.4, U11.1, U11.10, U11.12, U12.2, U12.5
GPS_PPS: R42.2, U9.36
GPS_RXD: U9.4, U11.3
GPS_TXD: U9.39, U11.2
unnamed: BT1.1, C103.1, U11.6
unnamed: C12.1, R4.2
unnamed: C17.1, R6.1, R7.1, R8.2, TP1.1
unnamed: C19.2, R18.1
unnamed: C22.2, R19.2, R21.1, U5.2
unnamed: C23.1, R20.1, R22.2, R23.1
unnamed: C23.2, R18.2, U5.4
unnamed: C26.2, C27.1, C29.2, C30.1, C35.2, C36.1, C42.1, C50.1, C57.1, L3.2, L4.1
unnamed: C27.2, C30.2, C31.1, C36.2, C37.1, C43.1, C51.1, C58.1, L4.2, L5.1
unnamed: C28.2, C32.2, C33.1, C38.2, C39.1, C46.1, C54.1, C61.1, L6.2, L7.1
unnamed: C33.2, C34.1, C39.2, C40.1, C47.1, C55.1, L7.2, L8.1
unnamed: C63.2, C67.2, C68.1, C74.1, L9.2, L10.1
unnamed: C64.1, C68.2, C69.1, C75.1, L10.2, L11.1
unnamed: C65.2, C66.1, C70.2, C71.1, C78.1, C83.1, L12.2, L13.1
unnamed: C66.2, C71.2, C72.1, C79.1, C84.1, C86.1, L13.2, L14.1
unnamed: C100.2, R38.1
unnamed: C105.1, L15.1, R41.2
unnamed: D1.2, L1.2, U1.5
unnamed: D11.2, R39.2
unnamed: D12.2, R40.2
unnamed: D13.1, J8.1, L15.2, U11.11
unnamed: C113.1, C114.1, C115.1, DS1.2, FB1.2
unnamed: J1.1, U3.9
unnamed: C24.1, J4.1, R23.2, U6.1
unnamed: J6.A5, R30.1, R31.1
unnamed: J6.B5, R32.1, R35.1
unnamed: L2.1, R8.1, R9.1, TP2.1
unnamed: C16.1, Q1.3, R7.2
unnamed: C16.2, Q1.1, R12.2, R16.1
unnamed: Q2.3, R16.2
unnamed: C19.1, C20.2, L2.2, Q3.1, Q4.1
unnamed: Q3.2, R20.2
unnamed: Q4.2, R22.1
unnamed: C87.2, C89.2, Q8.1, R27.2, R28.1
unnamed: R14.1, U4.1
unnamed: R43.2, R45.1, S1.2
unnamed: R44.2, R46.1, S2.2
unnamed: R47.2, R50.1, S3.2
unnamed: R48.2, R51.1, S4.2
unnamed: R49.2, R52.1, S5.2
unnamed: R53.2, R55.1, S6.2
unnamed: R54.2, R56.1, S7.2
unnamed: R4.1, U1.1
unnamed: R2.2, R3.1, U1.2
unnamed: C11.1, U1.8
unnamed: C5.1, U2.3
unnamed: C4.1, R1.2, U2.4
unnamed: R13.1, U3.19
unnamed: C14.2, R5.2, R11.1, U3.6
unnamed: C5.2, U3.1
unnamed: R33.2, R34.1, U8.8
unnamed: R29.2, U8.9
unnamed: C101.2, U9.34, Y1.2
unnamed: C102.2, U9.35, Y1.1
unnamed: C104.1, U10.5, U11.14
unnamed: R41.1, U10.1
unnamed: R42.1, U11.4
OLED_CS: DS1.7, U9.19
OLED_DC: DS1.6, U9.8
OLED_MOSI: DS1.4, U9.16
OLED_RES: DS1.5, U9.9
OLED_SCK: DS1.3, U9.18
SCL: Q9.1, R57.2, U3.4, U9.47, U12.1
SCL_5V: Q9.3, R59.2, U6.5
SDA: Q10.1, R58.2, U3.5, U9.46, U12.3
SDA_5V: Q10.3, R60.2, U6.4
SI_INTR: R15.2, U3.3, U9.7
TX: Q2.2, R17.1, R40.1, U9.48
TX_ISENSE: C18.1, R14.2, U9.31
