etherkit/OpenBeacon2/(commit log)

2017-12-03 New OpenBeacon Mini for 2017
    [OpenBeaconMini.kicad_pcb, OpenBeaconMini.sch]
2017-12-03 Add I2C level conversion
    [OpenBeaconMini.sch]
2018-01-30 Add firmware to repo
    [OpenBeaconMini.sch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]
2018-04-28 New firmware and time sync software
    [OpenBeaconMini.sch]
2018-05-07 Get TX timing correct
    [modes.h]
2018-05-12 Fix logic for reading band module
    [bands.h]
2018-06-01 Some ADC fixes
2018-06-05 Add mech dwgs for acrylic
    [OpenBeacon Mini Acrylic.dxf]
2018-08-30 Fix band ID algorithm to lock TX except when module removed
    [OpenBeacon Mini Acrylic.dxf, OpenBeaconMini-2018-07-16-20-27-20.sch, OpenBeaconMini_conflict-20180716-202745.sch]
2018-09-18 Add csv BOM
    [OpenBeaconMini-2018-09-18-14-19-17.sch, OpenBeaconMini_bom_A.csv]
2018-11-18 Reimplement config storage, implement flash NVM
    [OpenBeaconMini.sch]
2018-11-19 Fix missing holes in acrylic'
    [OpenBeacon Mini Acrylic.dxf]
2018-11-27 Fix wrong schematic in Documentation folder
2018-11-28 Initial schematic to Rev B
    [OpenBeaconMini.sch]
2018-11-28 Add debounce caps to buttons
    [OpenBeaconMini.sch]
2018-12-09 Initial sl support for FT8
    [OpenBeaconMini-B.Cu.gbl, OpenBeaconMini-B.Mask.gbs, OpenBeaconMini-B.SilkS.gbo, OpenBeaconMini-Edge.Cuts.gm1, OpenBeaconMini-F.Cu.gtl, OpenBeaconMini-F.Mask.gts, OpenBeaconMini-F.SilkS.gto, OpenBeaconMini.drl]
2018-12-10 Firmware support for Rev A and Rev B boards
2019-03-18 Add protocol document and test script
    [OpenBeaconMini-B.Cu.gbl, OpenBeaconMini-B.Mask.gbs, OpenBeaconMini-B.SilkS.gbo, OpenBeaconMini-Edge.Cuts.gm1, OpenBeaconMini-F.Cu.gtl, OpenBeaconMini-F.Mask.gts, OpenBeaconMini-F.SilkS.gto, OpenBeaconMini.drl]
2019-05-10 Add linux-arm build for Raspberry Pi
2019-05-12 Linux ARM build of obmsync
2019-09-17 Change name to OpenBeacon 2
    [OpenBeacon 2 Acrylic.dxf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]
2019-09-18 Generate ob2sync for linux-arm
2019-09-19 Fix fw where freq would show as 0 during startup
    [OpenBeacon2-B_Cu.gbl, OpenBeacon2-B_Mask.gbs, OpenBeacon2-B_SilkS.gbo, OpenBeacon2-F_Cu.gtl, OpenBeacon2-F_Mask.gts, OpenBeacon2-F_Paste.gtp, OpenBeacon2-F_SilkS.gto, OpenBeacon2.drl]
2019-10-07 Fix ArduinoJSON RAM corruption, tweak client
    [OpenBeacon2.ino, bands.h, modes.h, ob2sync.py]
2019-12-21 Update Linux ARM client
2019-12-26 Fix dfcw_offset from doing nothing
    [tx_state_machine.ino]
2019-12-27 Increase transmit guard band to 30 Hz
2019-12-30 Fix TX timing lag, buffer overflow in display code
    [OpenBeacon2.ino, buffer_compo.ino, buttons.ino, callbacks.ino, display.ino, screensaver.ino, serial.ino]
2020-08-24 Fix ArduinoJSON error in firmware
    [OpenBeacon2_conflict-20180716-202745.sch]
2020-08-24 Fix ArduinoJSON long long error, update linux-x86 client
    [ob2sync.py, serial.ino]
2020-08-25 Fix bug in tx disable in firmware
    [serial.ino, tx_state_machine.ino]
2026-10-25 Add relay-switched 4-filter LPF bank (80/60, 40/30, 20/17, 15/12/10)
    Convert schematic to KiCad 10 format and add filter_bank sheet:
    - Four 7th-order Cauer LPFs, each switched by two G6K-2F-Y-DC5 relays;
    unselected filters grounded at both ends via NC contacts
    - 2N7002 relay drivers with 1N4148W flyback diodes and 22k gate pulldowns
    - Remove plug-in LPF modules M1/M2, BAND_ID dividers and K1/K2 band relays
    - MCU control: D11=LPF_80_60, A0=LPF_40_30, A1=LPF_20_17, A5=LPF_15_10
    - Export schematic PDF to docs/
2026-10-25 Replace Empyrean SAMD21 module with AVR128DA32 + CP2102N USB-C/UPDI (from Si5351AVFO)
    - New sheet mcu_usb: AVR128DA32-I/PT, 32.768k crystal on PF0/PF1 with 15p loads,
    USB-C + SP0503 ESD, CP2102N with DTR auto-reset, LP2985-3.3, UPDI header
    - Remove U7 Empyrean from root sheet
    - Relay drivers Q6-Q9: 2N7002 -> AO3400A for 3.3 V gate drive
    - ERC 0 errors; schematic PDF regenerated; docs/VERIFY.md open items
2026-10-25 Add TX LED on TX keying net; fix USART1 pin assignment
    - D12 KT-0603YG (C2289) + R39 470R (C23179) from TX (PA4) to GND, ~2.6 mA
    - PC0/PC1 now UART_TX/UART_RX (USART1 default pins), LPF_15_10 moved to PC2
    - ERC 0 errors; PDF regenerated; VERIFY.md TX_LED item resolved
2026-10-25 Sync LED to yellow KT-0603Y with 470R; confirm UPDI matches Si5351AVFO/EtherKeyerMini
    - D11 KT-0603Y (C2287), R38 470R (C23179), ~2-3 mA
    - VERIFY.md: UPDI and sync LED items resolved; U1 FB stays open
    - ERC 0 errors; PDF regenerated
2026-10-25 VERIFY: resolve U1 FB item (FB tied to VIN selects internal 12 V output)
2026-10-25 Filter bank: 6-relay two-level tree driven by BAND_A/BAND_B
    Replace the 8-relay, 4-driver bank with a 2-bit tree (K1-K3 input,
    K4-K6 output, one G6K pole each). All relays off selects 80/60 m.
    Q6/Q7 AO3400A drive the first and second levels; PA7/PC2 freed.
2026-10-25 Add GPS option sheet (u-blox MAX-M10S) on USART2 ALT1
    - New pcb/gps.kicad_sch: MAX-M10S U12 on +3.3V (VIO_SEL open), UART to
    PF4/PF5, TIMEPULSE via 470R to GPS_PPS / J14, active-antenna bias-T
    (10R, 10n, 27nH per IM 4.3.4) to U.FL J15, supercap V_BCKP via
    1N5711W + 1k.
    - MCU: D4 moved PF4 -> PA7, sync LED moved PF5 -> PC2.
    - GPS_PPS MCU pin left open; options in VERIFY.md.
    - Regenerated schematic PDF; ERC 0 errors.
2026-10-25 GPS fixes: TPS22941 antenna current limit, TLV75533 500 mA LDO, CR1220 V_BCKP
    - U13 TPS22941 (C2653762) limits antenna short to 40-80 mA with auto-restart
    (avg <= 27 mA, was 320 mA); OC -> SDA as ANT_SHORT_N (IM 3.3.1.2)
    - U11 LP2985 -> TLV75533PDBVR (C404027), C35 removed (pin 4 NC)
    - C47/D13/R41 removed; BT1 CR1220 in KH-BS1220-2-SMT (C5365932)
    - VERIFY updated
2026-10-25 MCU: migrate to AVR128DA48-E/PT TQFP-48; GPS on USART3 PB0/PB1, GPS_PPS on async PF2 (EVSYS to TCB0 capture), per-pin decoupling
2026-10-25 Root sheet: redraw page 1 in rev C style (gen_main.py), A3, grouped blocks, Si5351A synth as a self-contained swap block
    kicad-cli netlist before/after: 149/149 nets with identical pin sets; 17 auto-named nets
    got readable labels (e.g. Net-(Q3-D) -> PA_DRAIN). No component, value or footprint changes.
2026-10-25 Replace Si5351A with Si5351C; add SMA CLKIN and CAL_CLK to PB2
    - U4 SI5351C-B-GMR (LCSC C2649375, alt SI5351C-B-GM C3608122), QFN-20 4x4 EP2.7, EP to GND
    - TCXO stays on XA (XB open); CLK0 to PA buffer and CLK2 to J6 unchanged
    - J16 BWSMA-KE-P001 (C496550) to CLKIN: 49.9R term, 100n AC coupling, 10k/10k VDD/2 bias
    - CLK4 -> R47 33R -> CAL_CLK -> PB2 (EVSYS CH0/1); PPS stays on PF2 (CH4/5)
    - OEB tied low; INTR 10k pull-up -> SI_INTR -> PB3
    - 100n on VDD and each VDDOx (C14, C50-C53)
    - VERIFY: Si5351C section, 10 s PPS-gated 32-bit TCB0/TCB1 cascade count
2026-10-25 BT1: KH-BS1220-2-SMT footprint from LCSC C5365932; J6/J16: Si5351BCBreakout SMA-ENDLAUNCH footprint, BWSMA-KE-P001 C496550; project-local OB2 footprint lib
2026-10-25 Restore hand-wired root sheet, add Si5351C wired, split root across two A4 sheets
    Root (A4) is the c2d4355 drawing with continuous wires: boost, keying, PA,
    bias DAC, filter bank, BNC out, plus the Si5351C (U4, C14/C50-C53, J6 CLK2,
    J16 CLKIN with R43/C54/R44/R45, R46 INTR pull-up, R47 CAL_CLK) drawn wired.
    I/O headers, OLED/buttons, I2C level shift and EEPROM move unchanged to the
    new io_ui.kicad_sch (A4). Netlist node sets identical to c569d37.
2026-10-25 J11: Amphenol RF 031-5431-10RFX MPN; mark DNP and exclude from position files (hand-soldered)
2026-10-25 Hide empty '~' pin names on EtherkitKicadLibrary R/C/ChipAttenuator, SN74LVC1G17, G6K-2; hide colliding OSCILLATOR pin names; regen PDF
2026-10-25 PA: replace EOL 2SK3074 Q3 with 2x onsemi BS170 (Q3, Q8; TO-92, DNP, hand-solder) in parallel, 10R gate stoppers R16/R17
2026-10-25 UI: 128x32 I2C OLED -> 1.3in SH1106 SPI 7-pin DS1 (as Si5351AVFO, DNP) on SPI1 ALT1 PC4/PC6 + CS PC7, DC PB4, RES PB5; FB1+C25-C27 rail filter; VFO 10k/10k/100n RC on all 7 buttons (R50-R63); D-pad s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
2026-10-25 UI: S1-S7 Omron B3F (4-pin) -> Kinghelm KH-6X6X11H-STM C2837537 as on Si5351AVFO (Switch:SW_Push 2-pin, OB2:SW_Push_6x6mm_SMD_KH-6X6X11H-STM footprint copied from VFO lib); pin1=GND, pin2=RC net; net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
2026-10-25 IO: Option B spare GPIO - J4 1x10 (D7/PA7, D17/PC3, D19/PC5, D38/A20/PF4, D39/A21/PF5, GND between), J5 1x12 (D22-D24/A0-A2/PD0-PD2, D31-D33/A9-A11/PE1-PE3, GND between); DxCore 48pin-standard net na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
2026-10-25 ESD: SP0503BAHT (C7074, already on BOM) at J4/J5 header pins + J14 PPS with 220R series (R64-R75, 0805 C17557 basic); ESD5V3U1U-02LRH (C3011174) on GPS RF_IN at U.FL J15; J5 moved under J4, header-si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
2026-10-25 ESD: SP0503BAHT (C7074) on J8 I2C (D19) and J10 UART (D20) with 220R series R76-R79 (C17557), header-side nets HDR_SCL/SDA/RX/TX; ESD5V3U1U-02LRH (C3011174) D21 on J16 CLKIN SMA, net CLKIN_SMA; regen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
2026-10-25 D21 on J16 CLKIN_SMA: bidirectional PESD5V0F1BL,315 (Nexperia, C45961, 0.4pF, VRWM 5.5V) replaces unidirectional ESD5V3U1U; Device:D_TVS_Small, SOD-882; regen PDF
2026-10-25 D18 on J15 GPS antenna: PESD5V0F1BL,315 (Nexperia, C45961) replaces TECH PUBLIC ESD5V3U1U copy (C3011174); Device:D_TVS_Small, SOD-882, same as D21; regen PDF
2026-10-25 Schematic style: pages 1-2 (root, I/O+UI) functional blocks in dashed boxes with titles and notes, matching other sheets; Si5351C block up 12.7 mm, PA/bias/filter-bank band down 6.35 mm, boost down 2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
2026-10-25 Schematic text cleanup: nudge C14/R13/R17 (root) and C17-C24 (I/O+UI) ref/value text off symbols and wires; shorten filter-bank and GPS title-block comments that overflowed the frame; no connectivity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
2026-10-25 U2 TCXO pin 1 to GND per YXC datasheet (was OE tied to VDD via DNP R13): rename symbol pin, ground with continuous wire, delete R13. Vendor EtherkitKicadLibrary/Measurement_Points footprints and proj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
2026-10-25 3D models: fix vendored Etherkit SOT23 model paths/scale/rotation, add ASTX 3225 TCXO model, vendor SW_6x6_H11_simple.step for S1-S7. Renumber duplicate #PWR901-926 power refs in gps/io_ui/mcu_usb (r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
2026-10-25 BOM: fill MPN/Manufacturer/LCSC for 47 Rev B parts (Basic preferred; C3 10u/25V, C7 1u/50V, C11 100n/50V). Hand-solder parts J11, Q3, Q8, DS1, L2 marked Assembly=hand solder and excluded from pos fil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
2026-10-25 Regenerate schematic PDF
2026-10-25 Exclude bare test pads J1, J2, J3, J9 from BOM
2026-10-25 LPF F2-F5: hand-wound T30 toroid design (1 W max); L1/C3 part swaps
    - Move F2-F5 to new nested A4 sheet "LPF Filters" (lpf_filters.kicad_sch),
    instantiated from Filter Bank; same F*_IN/F*_OUT nets to the relay tree.
    - 12 inductors -> hand-wound Micrometals T30-2 (F2/F3) / T30-6 (F4/F5),
    values/turns/wire per ob2_filters/t30 design. Fields: Core, Turns, Wire,
    MPN=T30-x, Supplier=Kits and Parts. DNP, excluded from pos files, no LCSC.
    Footprint Inductor_THT:L_Toroid_Vertical_L10.0mm_W5.0mm_P5.08mm.
    - All filter caps 0603 C0G/NP0 50 V JLC Basic/preferred, parallel combos
    as designed (C208+ etc.). C406/C407/C507 kept (still used; C407 now fitted).
    - Winding table + notes on the LPF shee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
2026-10-26 PCB layout pass 1: 100x120 4L outline, JLC 7628 stackup, VFO-pattern mounting holes, placement (no routing)
    - Board rebuilt from the merged KiCad 10 schematic (0406853); old KiCad 5 rev B board replaced
    - Stackup/rules/RF50 netclass (0.31 mm CPWG, 0.20 gap) from Si5351AVFO pcb-layout
    - DS1, S1/S2/S6 at VFO rev4 DS1/SW2/SW3/SW4 positions (+55 mm Y); D-pad cross at VFO encoder area
    - RF chain: Si5351/TCXO -> BS170 PA -> K1-K3 -> F2-F5 T30 columns -> K4-K6 -> J11 BNC (right edge)
    - CR1220 footprint: locating holes changed to NPTH (were zero-annulus PTH)
    - DRC: 0 errors, 0 parity issues; unrouted nets + silkscreen warnings only
2026-10-26 PCB placement: J11 BNC on back edge at filter output, reversed filter bank flow, aligned/labelled header row
2026-10-26 PCB Rev C re-place: 120x100 outline, back-edge J6/J16/J11/J12, BNC at filter-bank output, front-panel DS1/S1/S2/S6 + D-pad at VFO positions, header columns on 2.54 grid with labels
2026-10-26 PCB Rev C: tighter filter bank, USB-C J12 to back-left by SMAs, GPS moved away from RF chain, drop VFO holes H1/H2/H4, reference silk moved outside bodies
2026-10-26 PCB Rev C: nudge L503 clear of J11, VFO-style branding block with Etherkit+OSHW logos at front-right, Rev C on F.Cu at 0 deg
2026-10-26 PCB Rev C: GPS U.FL J15 + U12 to back-left edge beside USB-C, away from PA/filters/J11
2026-10-26 PCB Rev C: toroid column pitch 11.5->15 mm, PA beside K1, BT1 down, strict silk (no refs on courtyards), test-point function labels
2026-10-26 PCB Rev C: J11 BNC rotated 180 (faces back edge), L2 left for 1.2mm Q3 clearance, 38 silk leader lines; 3D models for J11/J6/J16/J12/L1/L2/U2/U4/U12/DS1/toroids, fix SOT23 model scale
2026-10-26 PCB Rev C: SMA J6/J16 spread to 16 mm c-c (15 mm from USB-C), J12 USB-C left, GPS U.FL J15 to left edge beside U12, synth U2/U4/U3 re-centred behind SMAs, toroid pitch 14 mm, K3 left for U9 clearance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
2026-10-26 PCB Rev C: lock approved connector/control/hole positions (J6 J16 J11 J12 J15 DS1 S1-S7 H3 H5-H7); gate check 6 enforces locked_positions.json
2026-10-26 S1-S7: Kinghelm KH-6X6X13H-STM 13 mm (C2837539); K5/K6 clear of case-bulkhead strip; gate check 7
2026-10-26 BT1 1.46 mm right: + pad was 0.45 mm inside the DS1 module outline, now 1.01 mm clear (D6/R56 nudged, C310 label); gate check 8 uses pads+courtyard and requires BT1 >= 1 mm
2026-10-27 GPS_TXD moved to U9 PF5 (pin 39, USART2 RXD ALT1): sch - PB1 NC, R68/HDR_D39 removed, J4.9/D14.3 NC; PCB - GPS_TXD 84 mm west part + new 75 mm east run, torn-up header/LED nets rerouted, HDR_D23 hand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
2026-10-27 Add the firmware2 M0 skeleton, DxCore CI, and Rev C pin map.
    The AVR128DA48 stub builds with arduino-cli and DxCore 1.6.2. Host tests lock the pin header to spec sections 2.1 and 2.2, including the uncommitted power-rework nets.
2026-10-28 Rev C layout: board grown to 130x110 mm, headers J4/J5/J8/J10/J14 removed, power rework layout
    - Outline grown 10 mm on top and left edges (130x110 mm); locked edge parts moved with outline
    - Removed J4, J5, J8, J10, J14 and support parts (D13-D15, D17, D19, D20, R64-R67, R69-R71, R75-R79); UPDI J13 kept
    - Power rework placed and routed (TPS61085 boost, INA193 U14, Q10 soft-start)
    - Y1 placed at U9, stray passives moved, silkscreen labels cleaned up
    - Routed: DRC 0 errors / 0 unconnected, schematic parity 0, ERC 0; layout gate 11/11
    - DRU: ESC_* fine-pitch escape 0.20 mm rule areas, U1 pad-to-pad 0.14 mm
    - In2 keep-away waivers (GND-plane shielded): Q2 drain, MCU_TX, MCU_RX near R6, 22.6 mm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
2026-10-28 CI: regenerate schematic PDF into docs/ on push
2026-10-28 Regenerate schematic PDF [skip ci]
2026-10-28 PCB silk touchup
2026-10-28 Center board on A4 drawing sheet (offset -6,-40 mm); DRC 0/0
2026-10-28 Renumber all references monotonically 1..N per prefix; sync PCB silk labels and auto-named nets; ERC 0, DRC 0/0
2026-10-28 Add 3D model links to BNC, BN2402 and SMA-ENDLAUNCH library footprints
