etherkit/OpenBeacon2/(notices)

Notices in the files:
pcb/OpenBeacon2.kicad_pcb:
Creative Commons License 4.0 CC-BY-SA
CC-BY-SA 4.0
